capotostobnl/acmi2-hw-afe/3dmodels/TPS3850H33DRCR.STEP

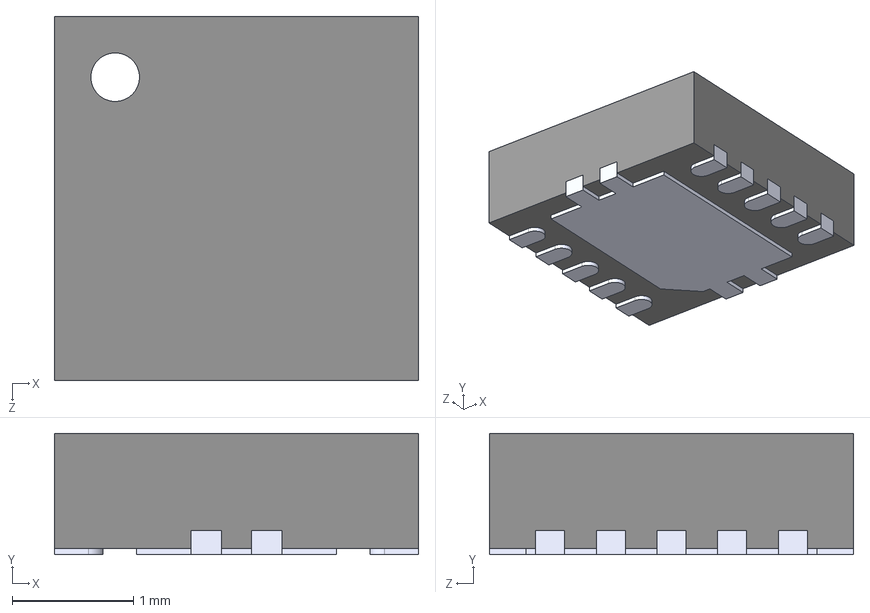
[picture p1: CAD file, 2026-05-26]
3dmodels/TPS3850H33DRCR.STEP
3.00 x 1.00 x 3.00 mm
