capotostobnl/acmi2-hw-afe/3dmodels/EEE-FTH101XAP.step

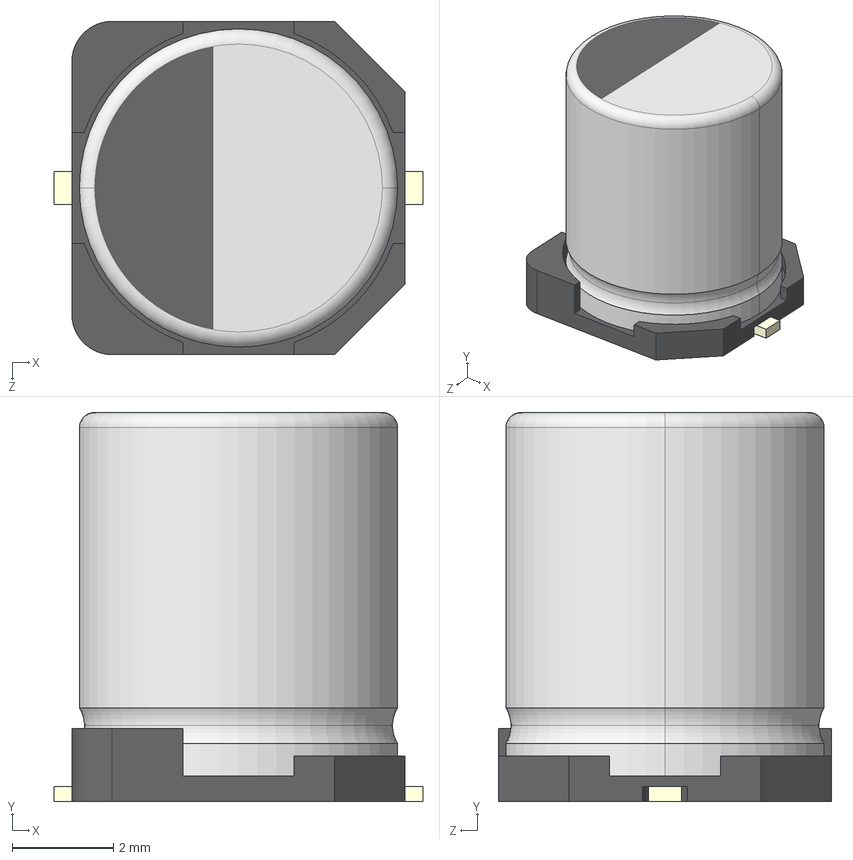
[picture p2: CAD file, 2026-04-29]
3dmodels/EEE-FTH101XAP.step
7.30 x 7.70 x 6.60 mm
標準SIZE CODE D8-001
標準SIZE CODE D8-002
標準SIZE CODE D8-003 x 2
