capotostobnl/acmi2-hw-afe/3dmodels/c-1625854-1-ba-3d.step

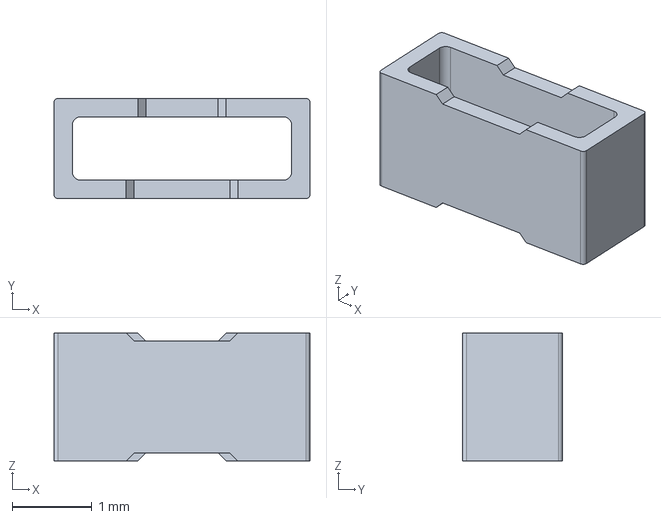
[picture p3: CAD file, 2026-04-29]
3dmodels/c-1625854-1-ba-3d.step
3.20 x 1.25 x 1.60 mm
