capotostobnl/acmi2-hw-afe/3dmodels/FUSE_SMDC300F24-2_LTF.step

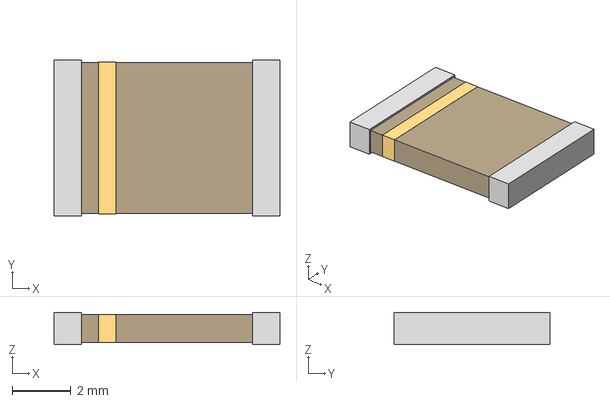
[picture p4: CAD file, 2026-04-29]
3dmodels/FUSE_SMDC300F24-2_LTF.step
7.70 x 5.31 x 1.09 mm
