capotostobnl/acmi2-hw-afe/3dmodels/KRL2012E-M-R220-F-T5.step

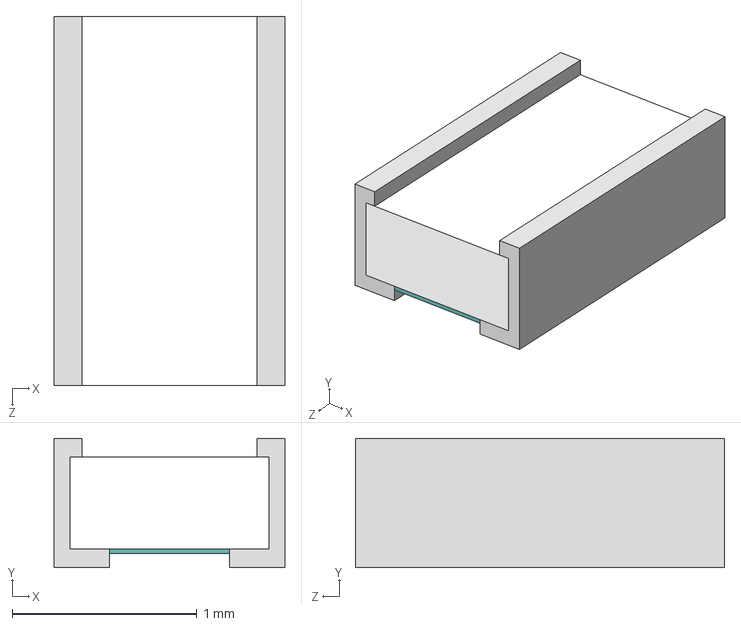
[picture p5: CAD file, 2026-04-29]
3dmodels/KRL2012E-M-R220-F-T5.step
1.25 x 0.7 x 2.00 mm
