capotostobnl/acmi2-hw-afe/3dmodels/SN74LVC16T245DGGR.STEP

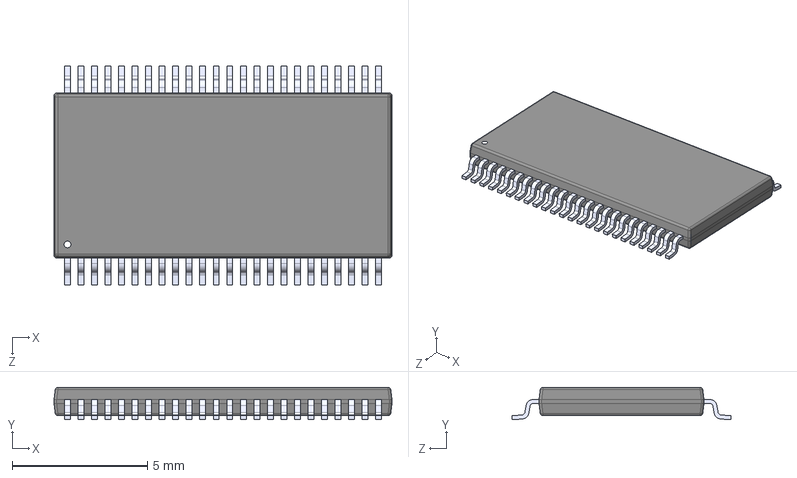
[picture p6: CAD file, 2026-04-29]
3dmodels/SN74LVC16T245DGGR.STEP
12.5 x 1.20 x 8.10 mm
