capotostobnl/acmi2-hw-afe/3dmodels/LTC2991CMS_TRPBF.step

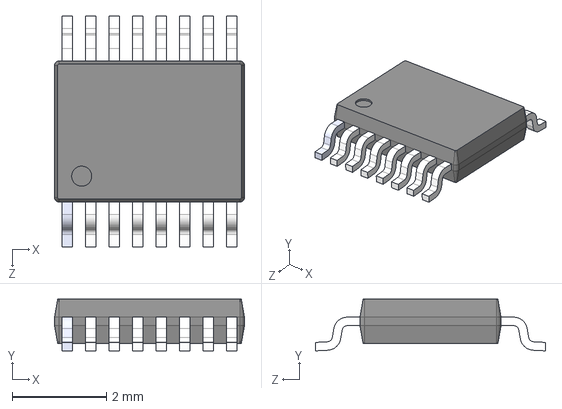
[picture p7: CAD file, 2026-04-29]
3dmodels/LTC2991CMS_TRPBF.step
4.04 x 1.10 x 4.90 mm
