capotostobnl/acmi2-hw-afe/3dmodels/RES_6432_SUS.step

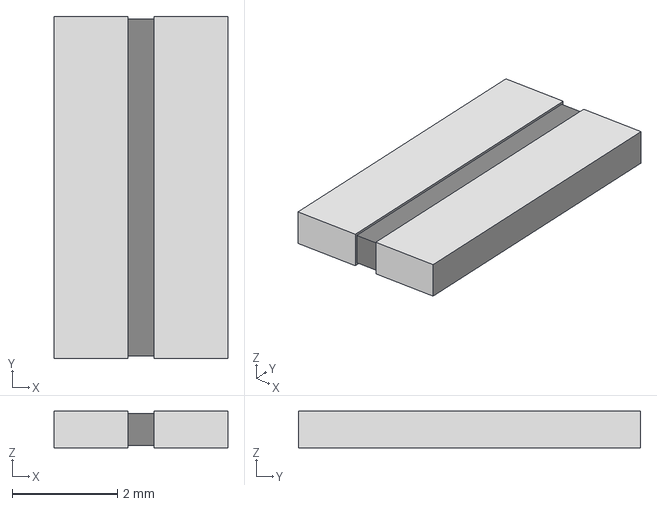
[picture p8: CAD file, 2026-04-29]
3dmodels/RES_6432_SUS.step
3.30 x 6.50 x 0.7 mm
