capotostobnl/acmi2-hw-afe/3dmodels/MSOP-8_MS_LIT.step

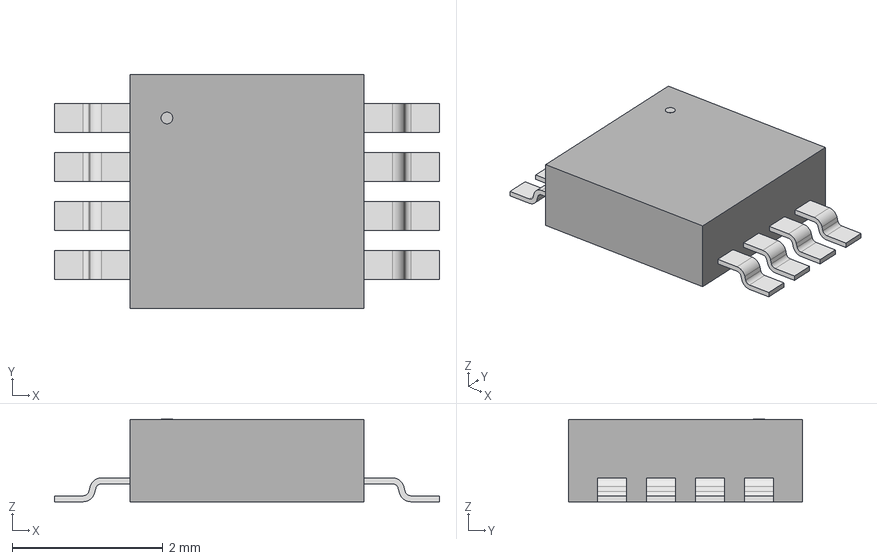
[picture p9: CAD file, 2026-04-29]
3dmodels/MSOP-8_MS_LIT.step
5.11 x 3.10 x 1.09 mm
