capotostobnl/acmi2-hw-afe/3dmodels/3-641215-6-z-3d.step

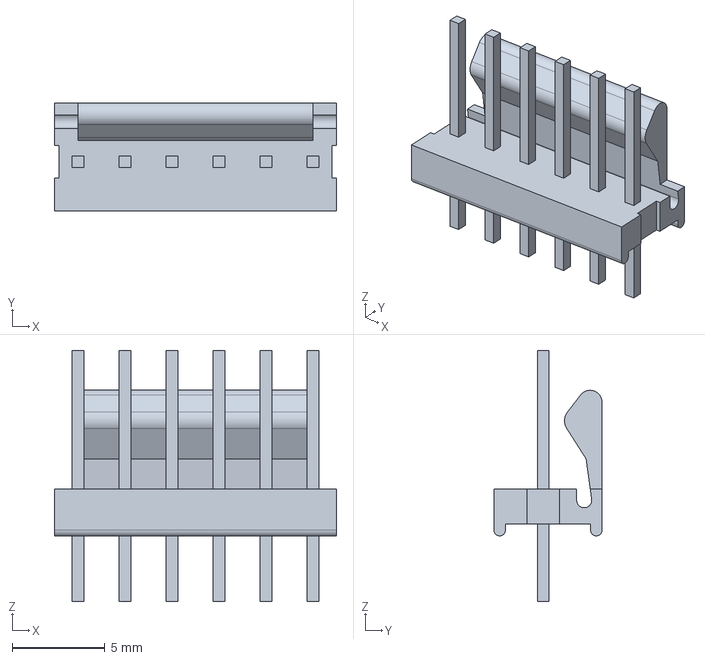
[picture p10: CAD file, 2026-04-29]
3dmodels/3-641215-6-z-3d.step
15.2 x 5.84 x 13.6 mm
