capotostobnl/acmi2-hw-afe/3dmodels/Coilcraft-MSS1048.step

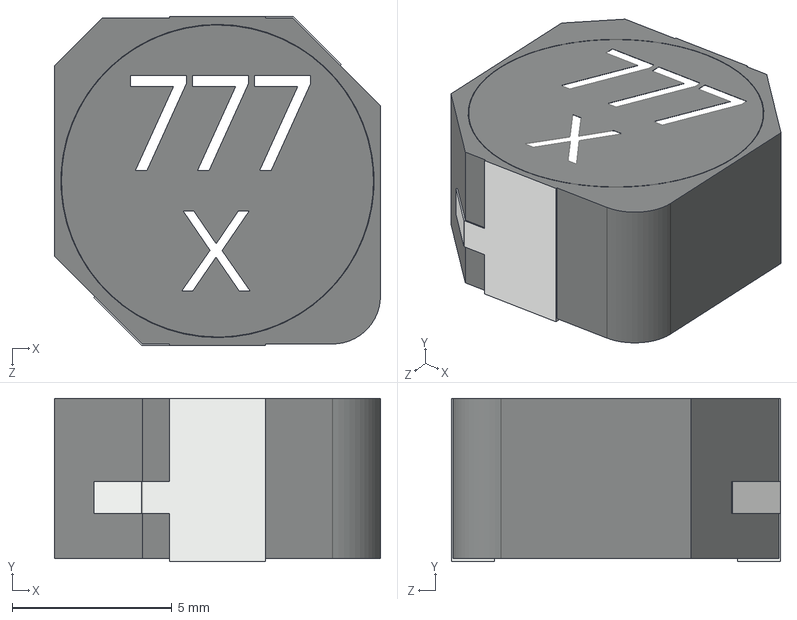
[picture p11: CAD file, 2026-04-29]
3dmodels/Coilcraft-MSS1048.step
10.2 x 5.10 x 10.3 mm
