capotostobnl/acmi2-hw-afe/3dmodels/Amphenol_10090926-P264XLF.step

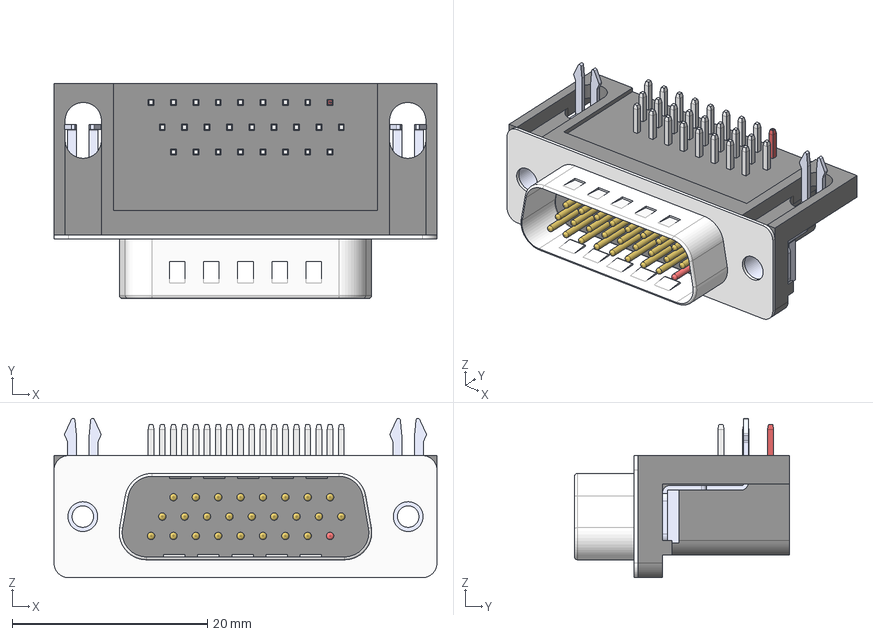
[picture p12: CAD file, 2026-04-29]
3dmodels/Amphenol_10090926-P264XLF.step
39.2 x 22.0 x 16.3 mm
