capotostobnl/acmi2-hw-afe/3dmodels/RDM0023A.stp

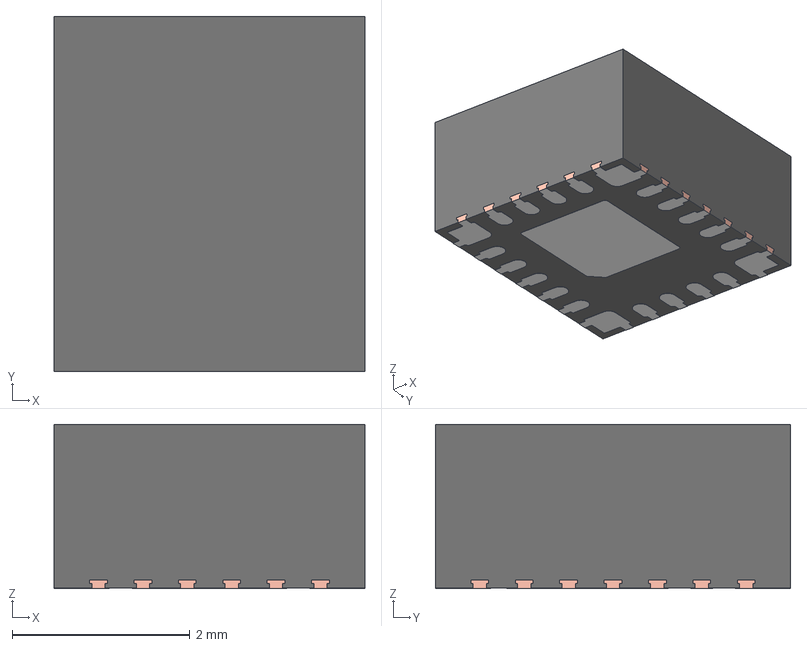
[picture p13: CAD file, 2026-04-29]
3dmodels/RDM0023A.stp
3.50 x 4.00 x 1.85 mm
FRAME
MOLD
