capotostobnl/acmi2-hw-afe/3dmodels/T521X107M025ATE060.step

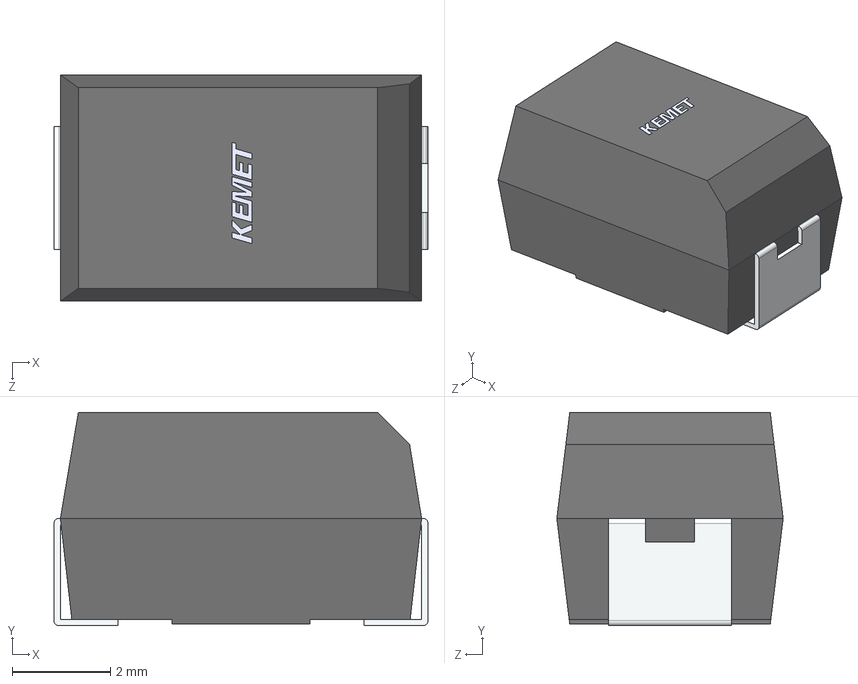
[picture p14: CAD file, 2026-04-29]
3dmodels/T521X107M025ATE060.step
7.60 x 4.34 x 4.60 mm
