capotostobnl/acmi2-hw-afe/3dmodels/ECS-LVDS33-2000-BN.STEP

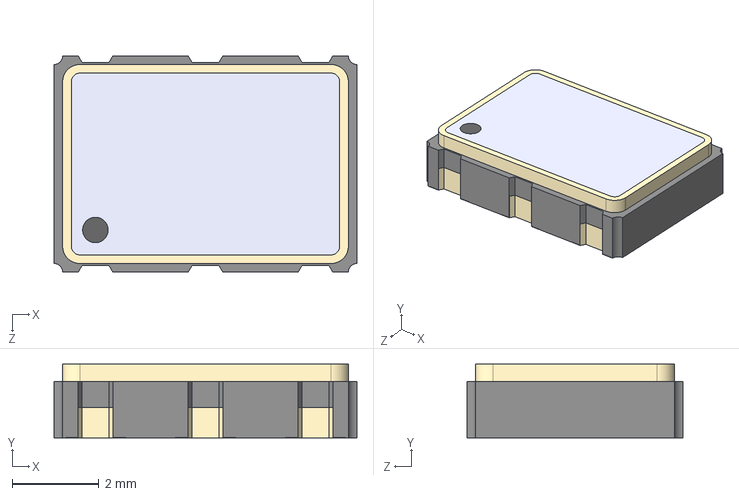
[picture p15: CAD file, 2026-04-29]
3dmodels/ECS-LVDS33-2000-BN.STEP
7.00 x 1.70 x 5.00 mm
