capotostobnl/acmi2-hw-afe/3dmodels/TPS7A8500RGRT.STEP

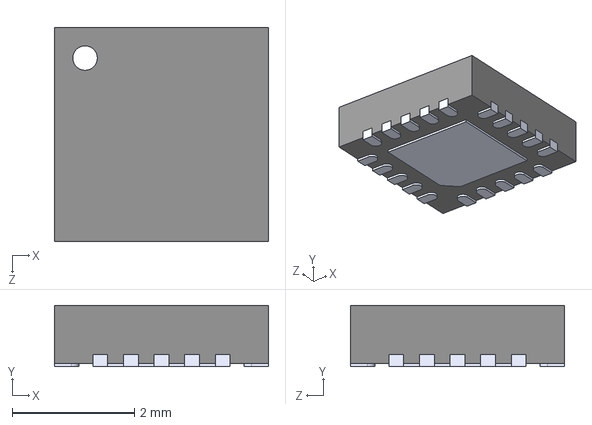
[picture p16: CAD file, 2026-04-29]
3dmodels/TPS7A8500RGRT.STEP
3.50 x 1.00 x 3.50 mm
