capotostobnl/acmi2-hw-afe/3dmodels/LT3015EDDPBF.step

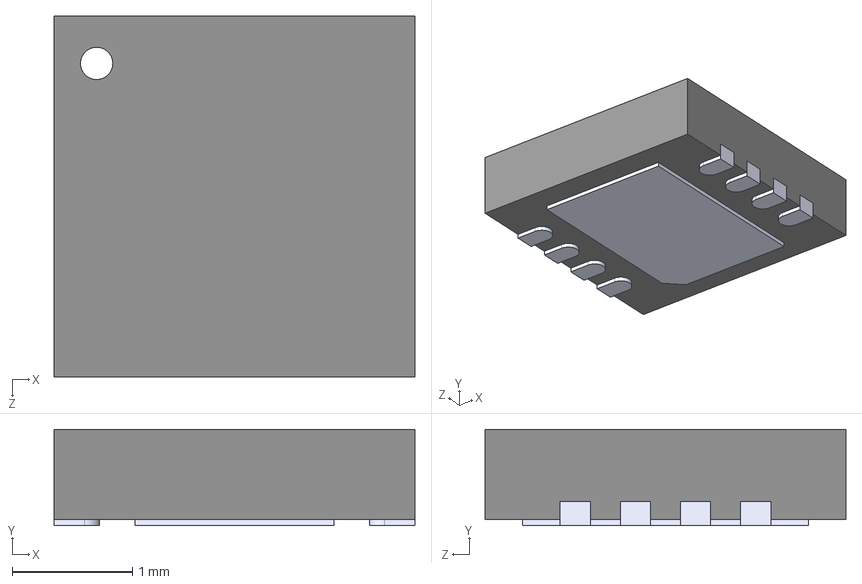
[picture p17: CAD file, 2026-04-29]
3dmodels/LT3015EDDPBF.step
3.00 x 0.8 x 3.00 mm
