capotostobnl/acmi2-hw-afe/3dmodels/PW0016A.step

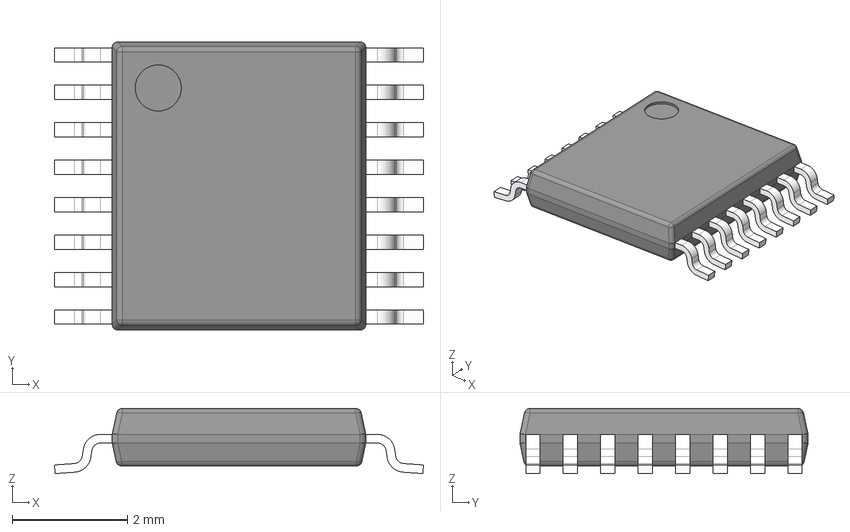
[picture p18: CAD file, 2026-04-29]
3dmodels/PW0016A.step
6.40 x 5.00 x 1.13 mm
BODY-TSSOP
LEAD-TSSOP x 16
PIN1
