capotostobnl/acmi2-hw-afe/3dmodels/IND_LSMG_160808_TAY.step

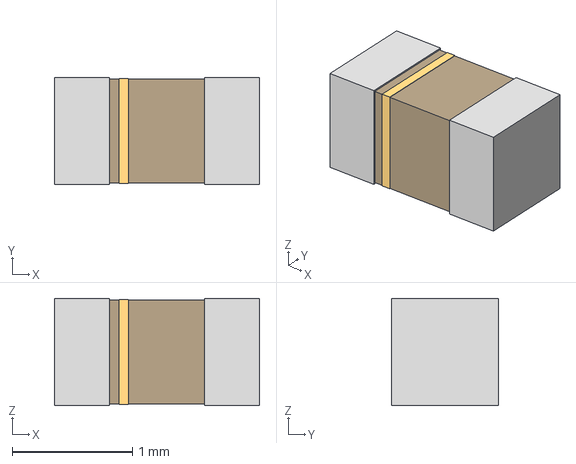
[picture p19: CAD file, 2026-04-29]
3dmodels/IND_LSMG_160808_TAY.step
1.70 x 0.888 x 0.889 mm
