capotostobnl/acmi2-hw-afe/(list of files, cad)

Other CAD files:
3dmodels/039301022.step
3dmodels/132134.stp
3dmodels/39301022.step
3dmodels/5499922-4-3d.stp
3dmodels/61082-061400LF.step
3dmodels/6469028-1.step
3dmodels/836149012.step
3dmodels/CAT25320VI-GT3.STEP
3dmodels/TPS259540DSGR.STEP
