capotostobnl/acmi2-hw-afe/Outputs/STEP/SK-2601-52_Rev-1_bottom.png

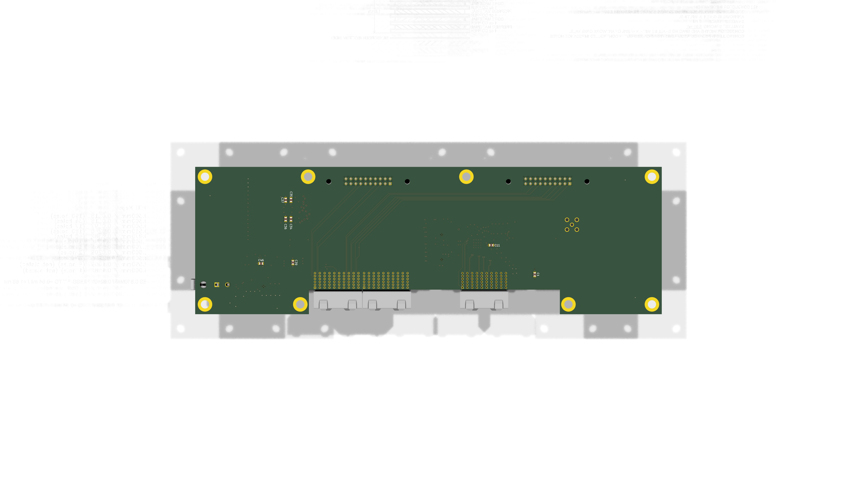
Outputs/STEP/SK-2601-52_Rev-1_bottom.png
