capotostobnl/acmi2-hw-afe/Outputs/STEP/SK-2601-52_Rev-1_top.png

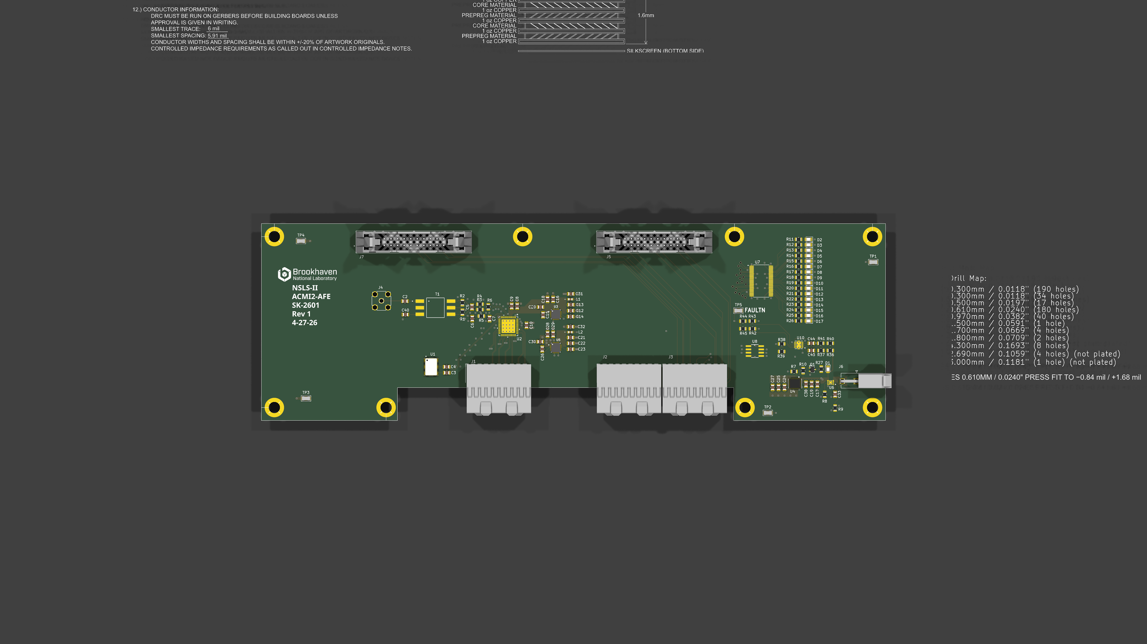
Outputs/STEP/SK-2601-52_Rev-1_top.png
