capotostobnl/acmi2-hw-afe/Outputs/ASSY/SK-2601-51_Rev-1.pdf

1 | 2 | 3 | 4 | 5 | 6 | 7 | 8 | 9 | 10 | 11

A

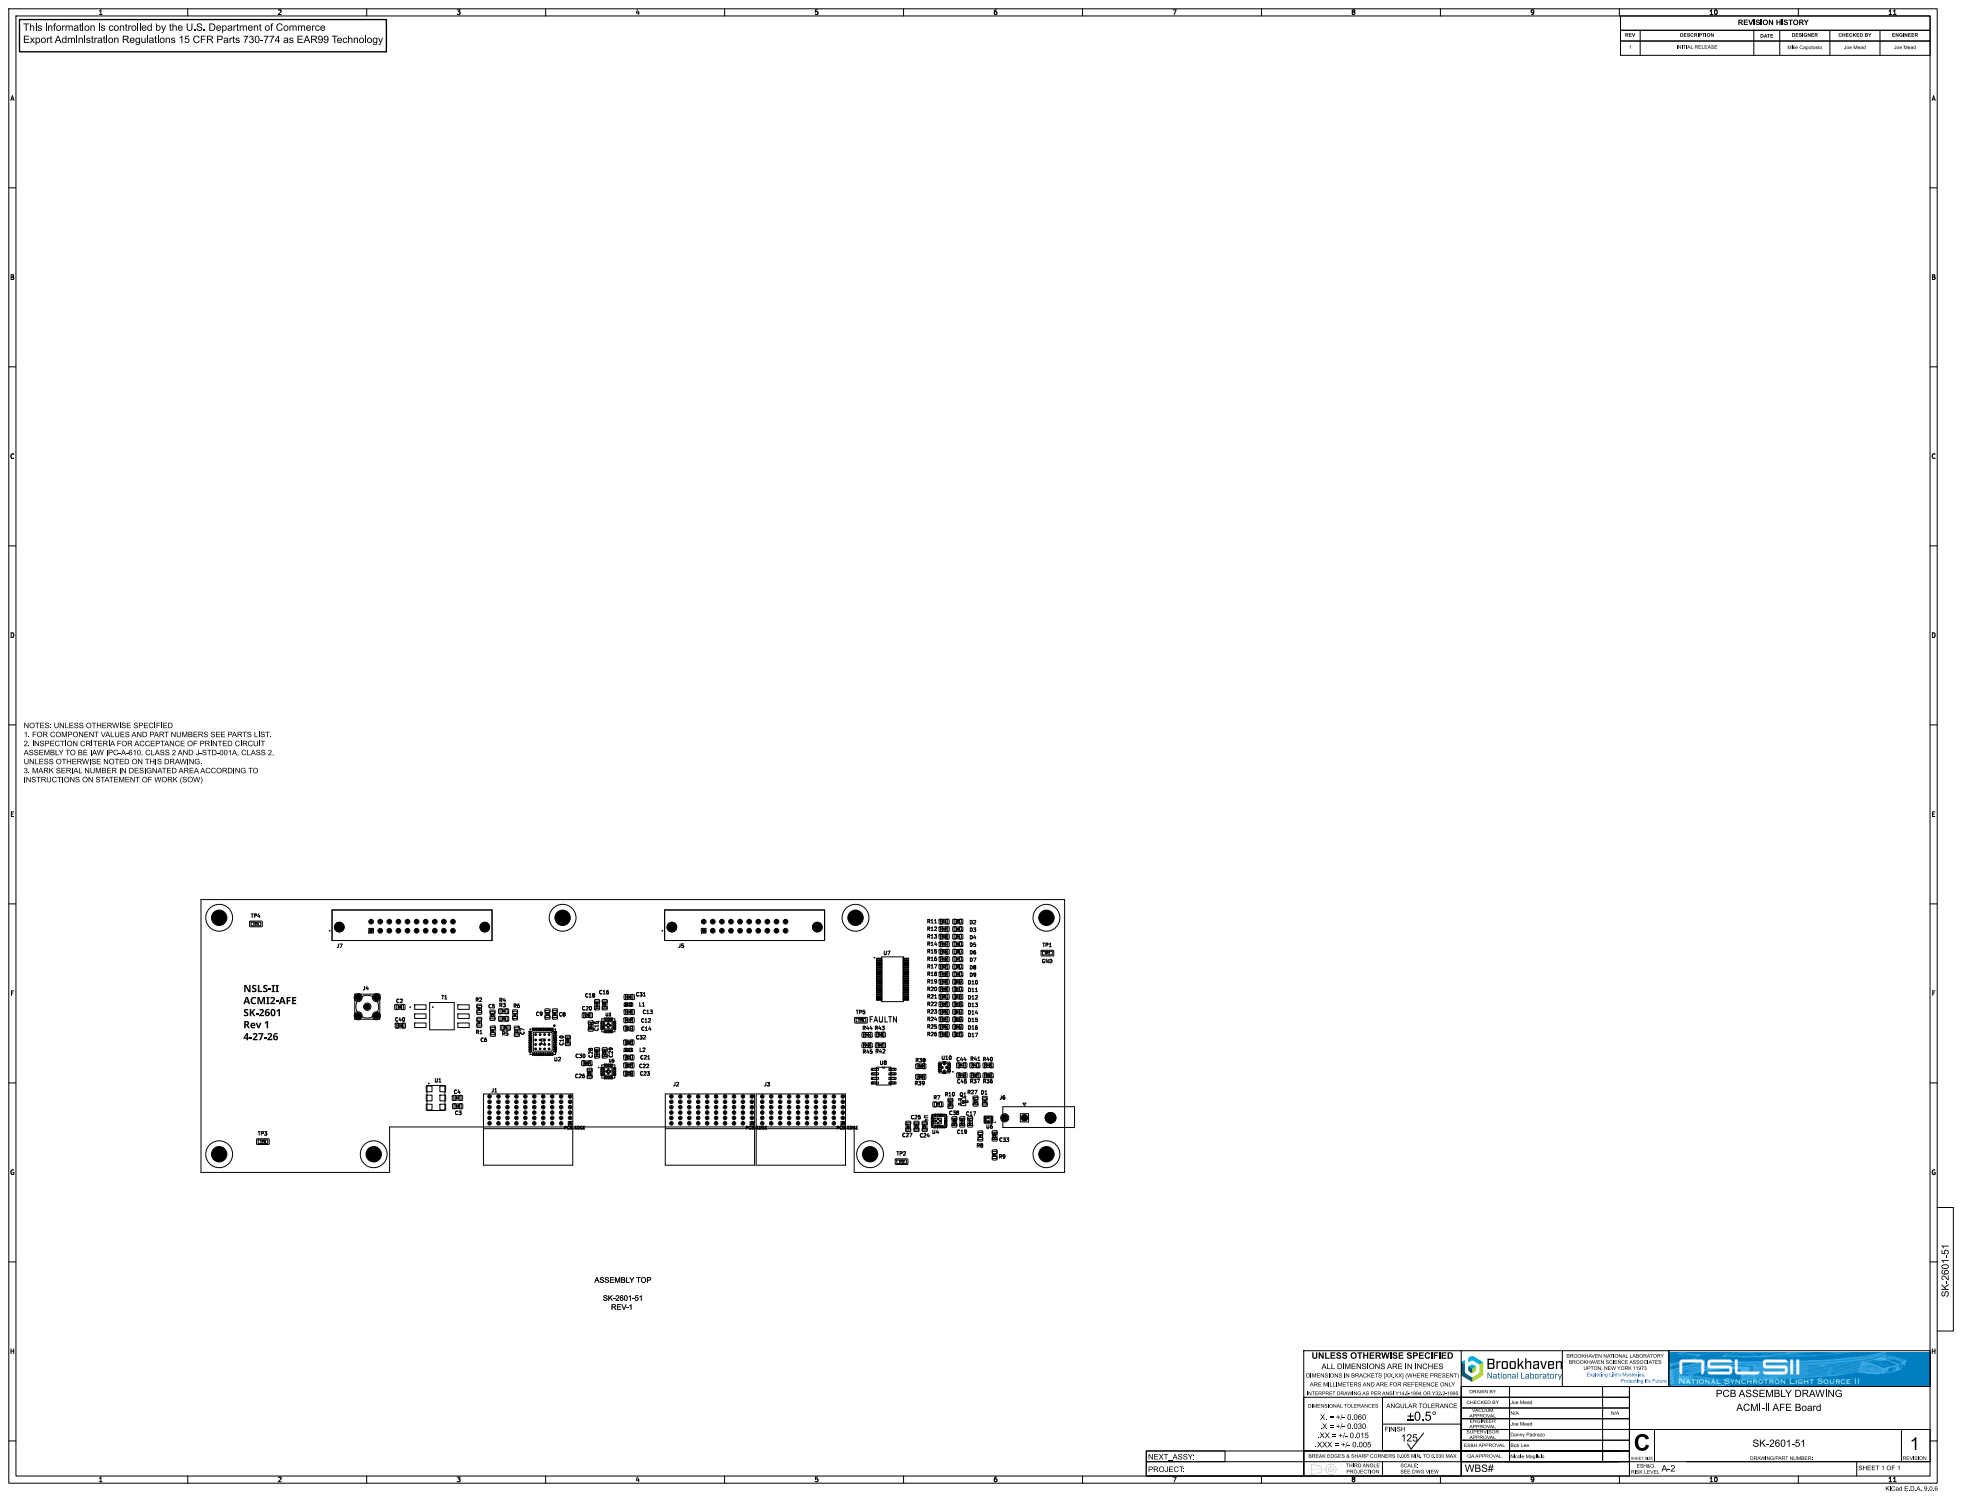
[picture p25: page 1]

This information is controlled by the U.S. Department of Commerce

SEE DWG VIEW UNLESS OTHERWISE SPECIFIED
ALL DIMENSIONS ARE IN INCHES
DIMENSIONS IN BRACKETS [XX.XX] (WHERE PRESENT) ARE MILLIMETERS AND ARE FOR REFERENCE ONLY

Exploring Life's Mysteries, Protecting it's Future PROJECT:

DRAWN BY QA APPROVAL SUPERVISOR
Joe Mead Bob Lee CHECKED BY

PCB ASSEMBLY DRAWING
ACMI-II AFE Board

BREAK EDGES & SHARP CORNERS 0.005 MIN. TO 0.030 MAX

1 | 2 | 3 | 4 | 5 | 6 | 7 | 8 | 9 | 10 | 11

A

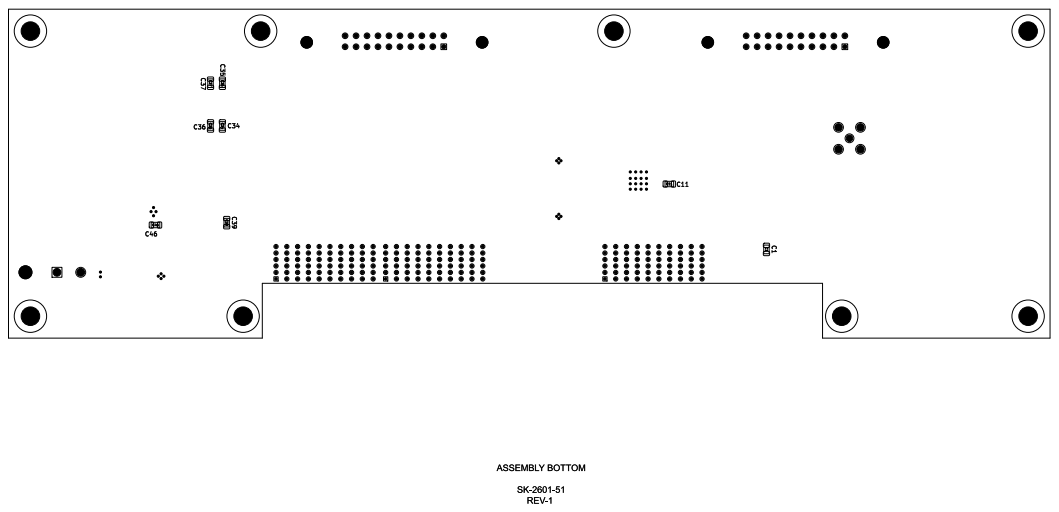
[picture p26: page 2]

This information is controlled by the U.S. Department of Commerce
