capotostobnl/acmi2-hw-afe/Outputs/FAB/SK-2601-52_Rev-1.pdf

## This information is controlled by the U.S. Department of Commerce

Export | Administration Regulations 15 CFR Parts 730-774 as EAR99 Technology | Not specified Controlled | Impedance | Top and Bottom Layers

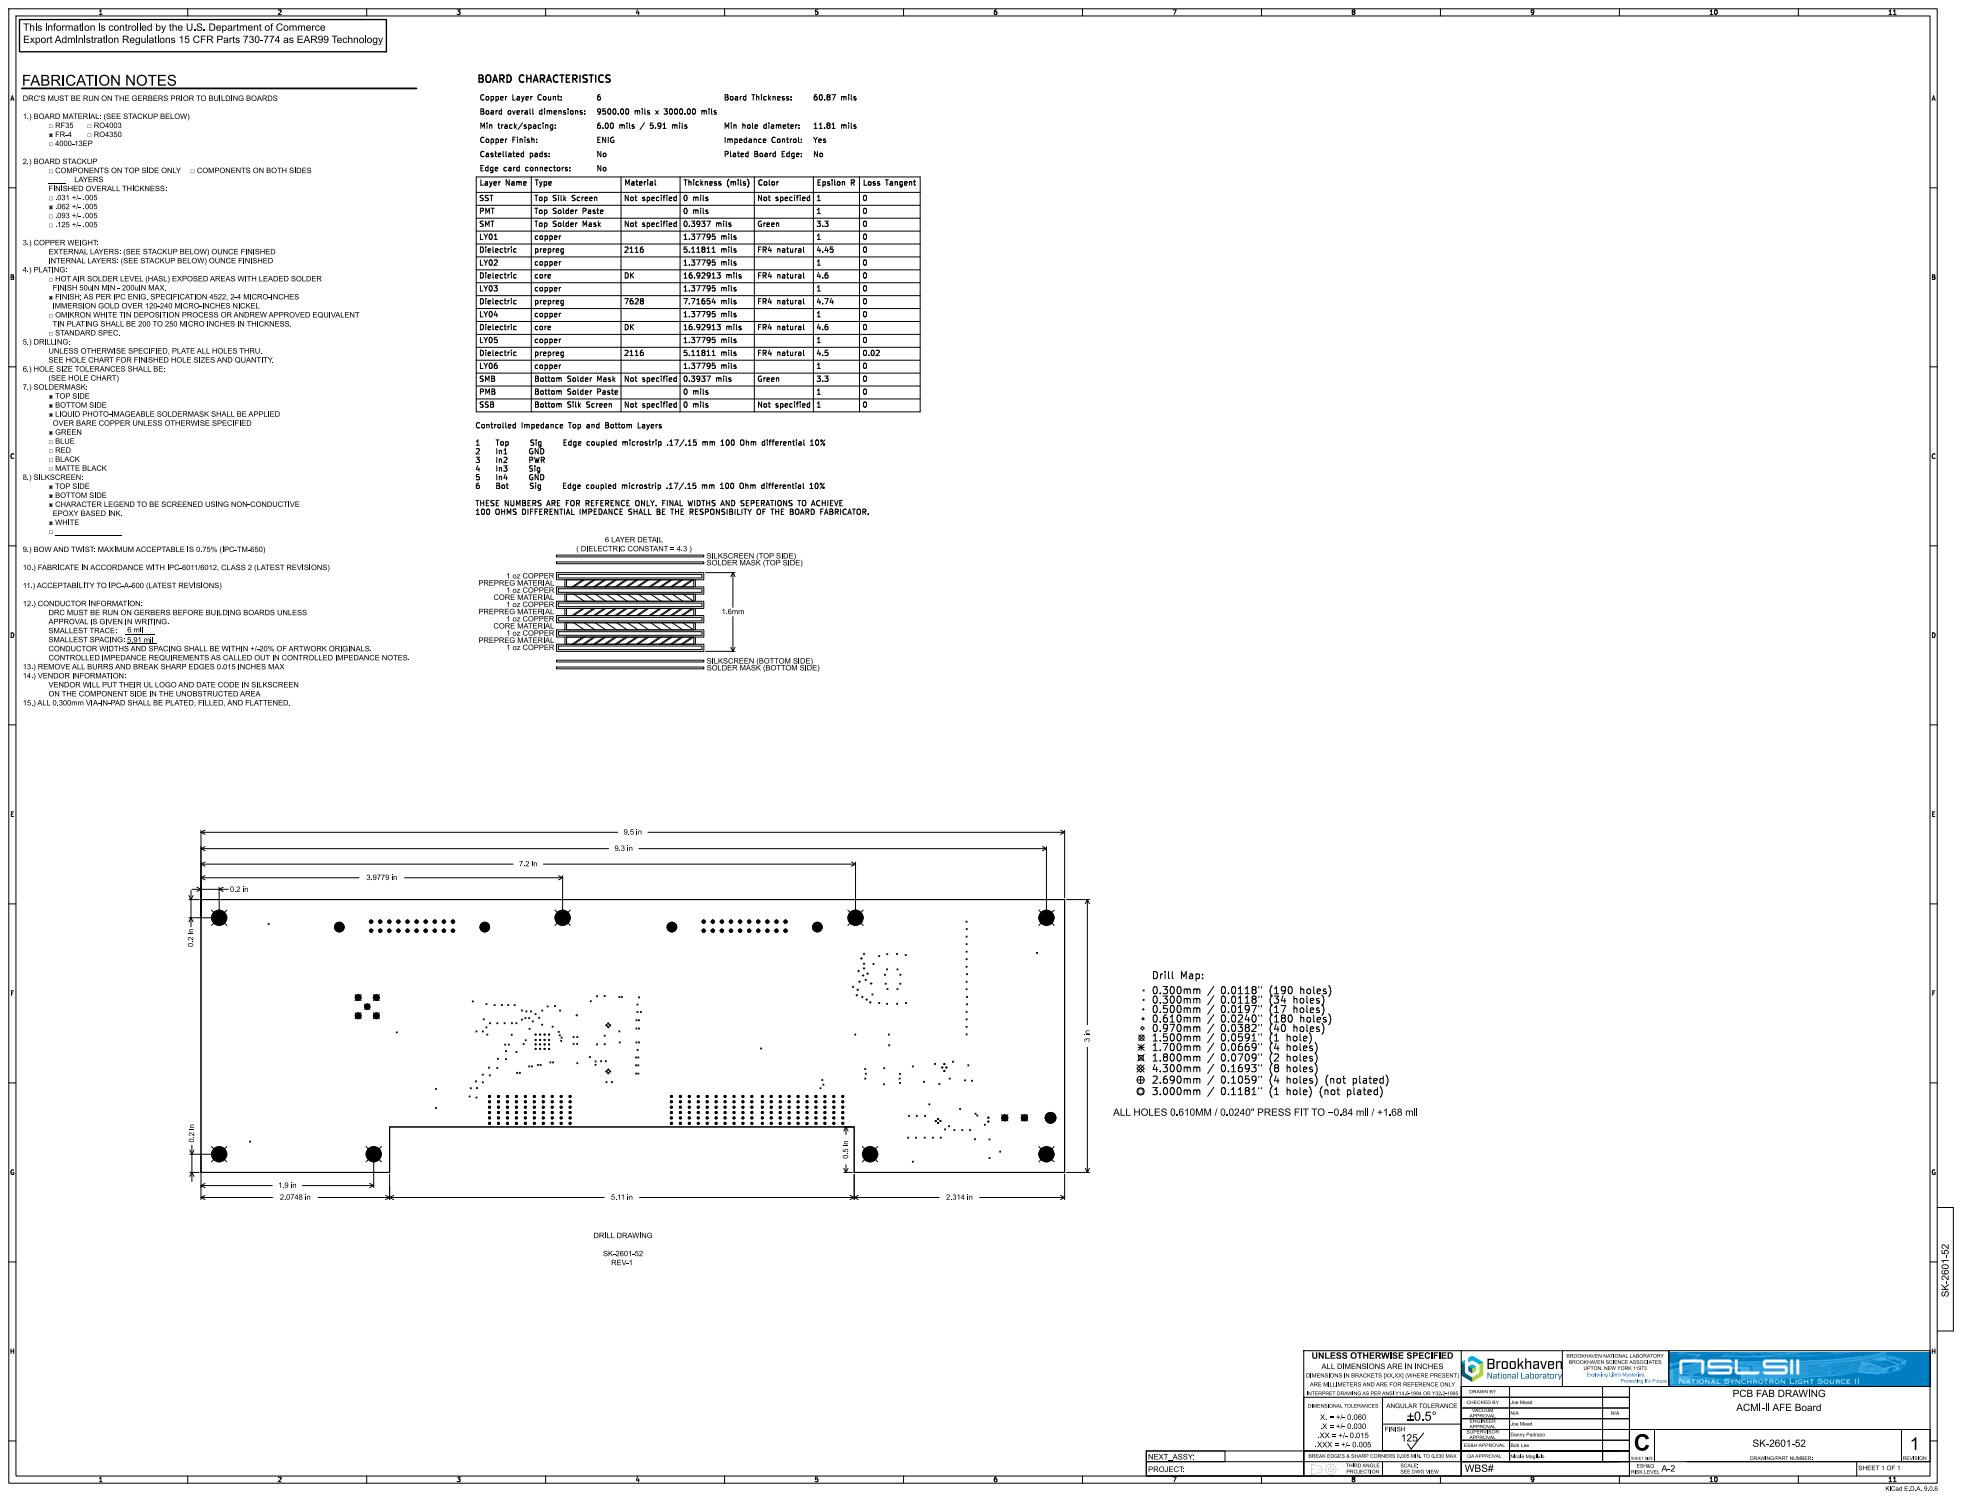
[picture p27: page 1]
SHEET SIZE; DRAWING/PART NUMBER:; REVISION; ESH&Q; RISK LEVEL; SHEET 1 OF 1; KiCad E.D.A. 9.0.6 SK-2601-52; Joe Mead Nicole Magliulo; VACUUM; APPROVAL; Danny Padrazo ES&H APPROVAL; ENGINEER; APPROVAL WBS#; .XXX = +/- 0.005; FINISH125; ANGULAR TOLERANCE; THIRD ANGLE; PROJECTION SCALE:; INTERPRET DRAWING AS PER ANSI Y14.5-1994 OR Y32.2-1995; BROOKHAVEN NATIONAL LABORATORY; 1 Top; þÿSig  Edge coupled microstrip; mm 100 Ohm differential; GND; þÿGND  6 Bot; Sig þÿ Edge coupled microstrip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

0 Yes Bottom Silk Screen PMT BOARD CHARACTERISTICS

0 ENIG
1.37795 mils Not specified No

Loss Tangent SMB

Type
1 Top Silk Screen

0 mils 1.37795 mils Not specified

7.71654 mils Not specified

THESE NUMBERS ARE FOR REFERENCE ONLY. FINAL WIDTHS AND SEPERATIONS TO ACHIEVE

H SK⁻²⁶⁰¹⁻⁵²

UPTON, NEW YORK 11973 NEXT_ASSY:

SEE DWG VIEW UNLESS OTHERWISE SPECIFIED
ALL DIMENSIONS ARE IN INCHES
DIMENSIONS IN BRACKETS [XX.XX] (WHERE PRESENT) ARE MILLIMETERS AND ARE FOR REFERENCE ONLY

BROOKHAVEN SCIENCE ASSOCIATES

Exploring Life's Mysteries, Protecting it's Future PROJECT:

DRAWN BY QA APPROVAL SUPERVISOR
Joe Mead Bob Lee CHECKED BY

PCB FAB DRAWING
ACMI-II AFE Board

APPROVAL DIMENSIONAL TOLERANCES X. = +/- 0.060

BREAK EDGES & SHARP CORNERS 0.005 MIN. TO 0.030 MAX

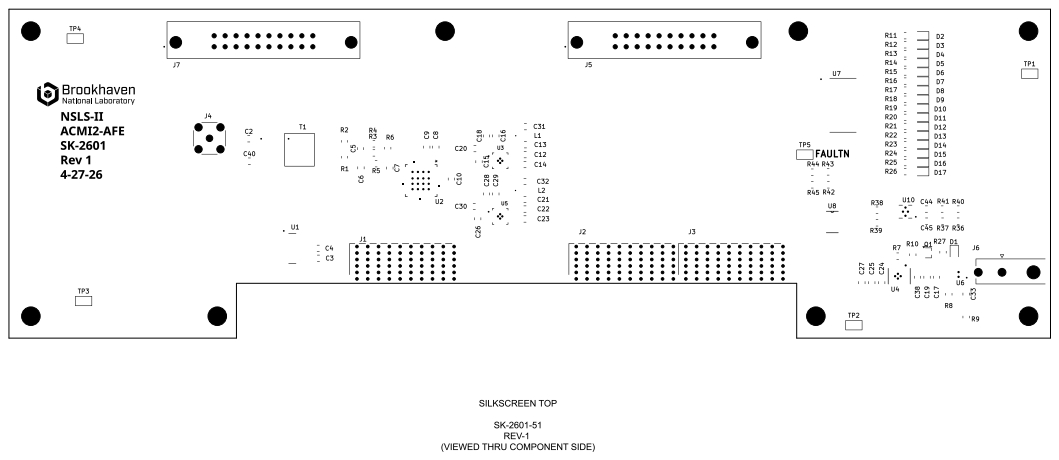
[picture p28: page 2]

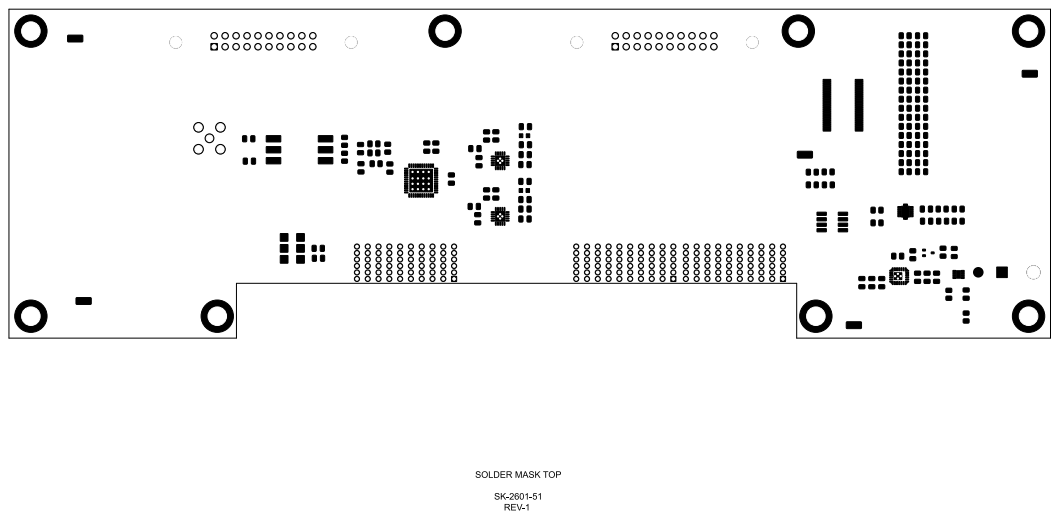
[picture p29: page 3]

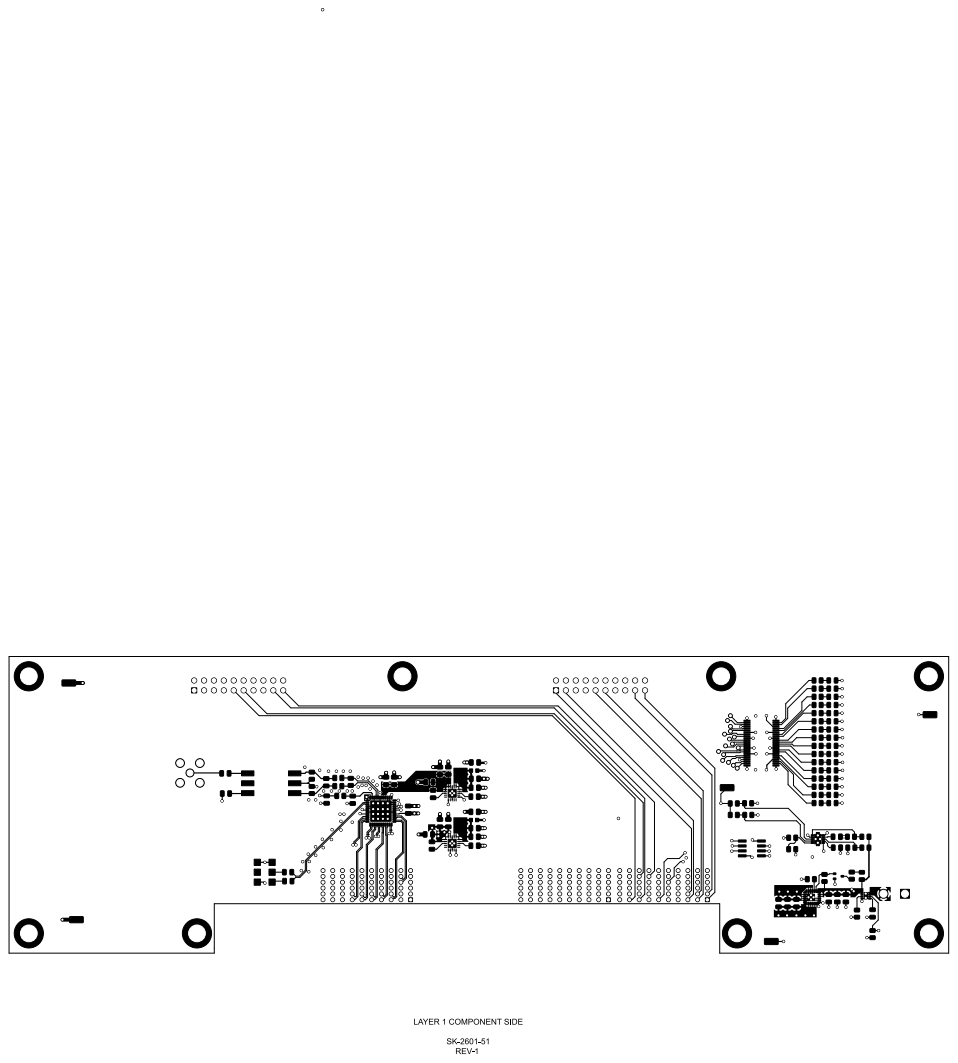
[picture p30: page 4]

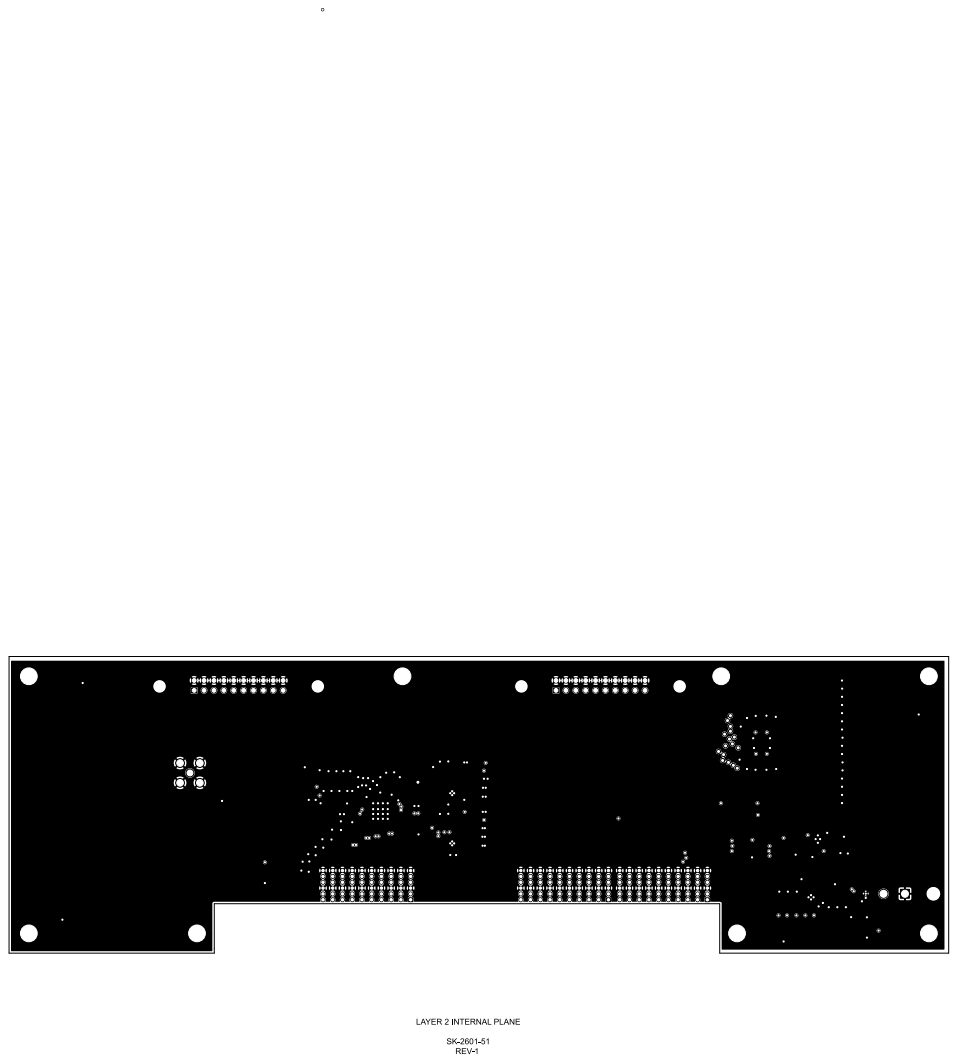
[picture p31: page 5]

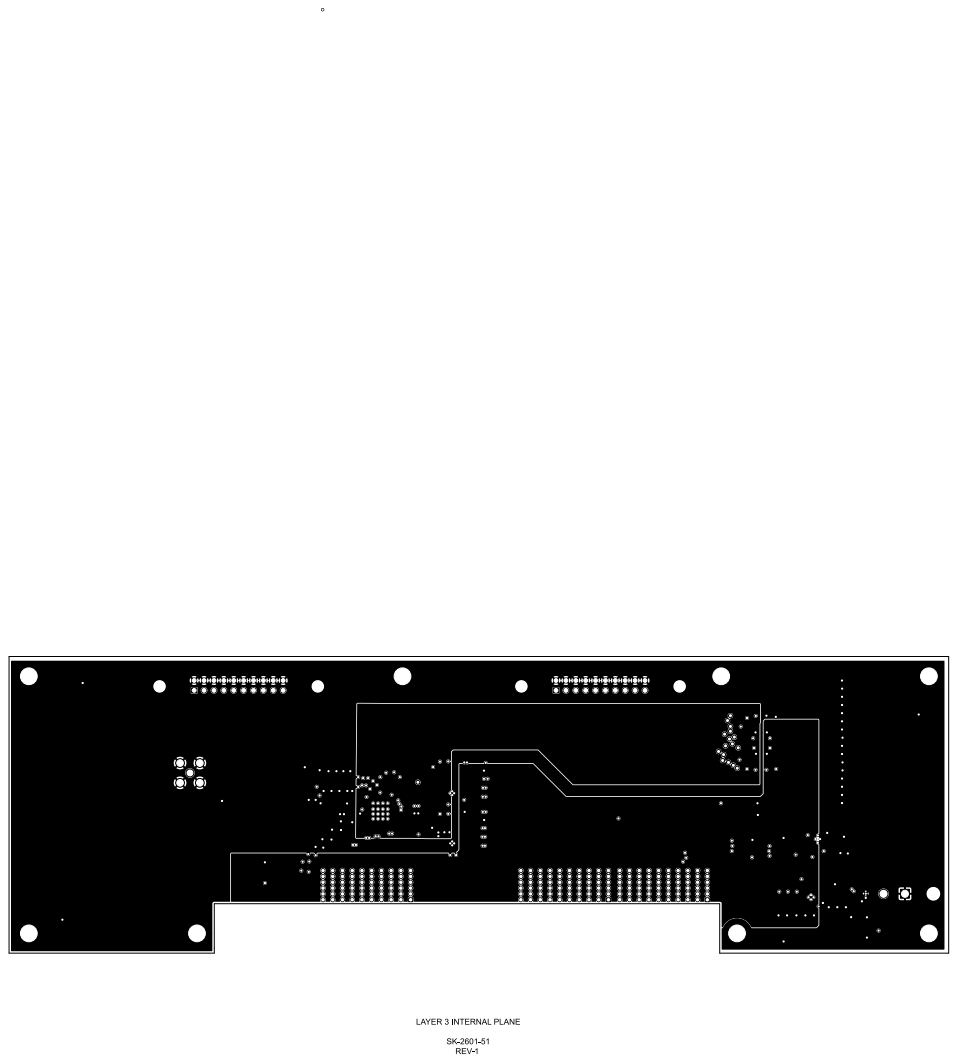
[picture p32: page 6]

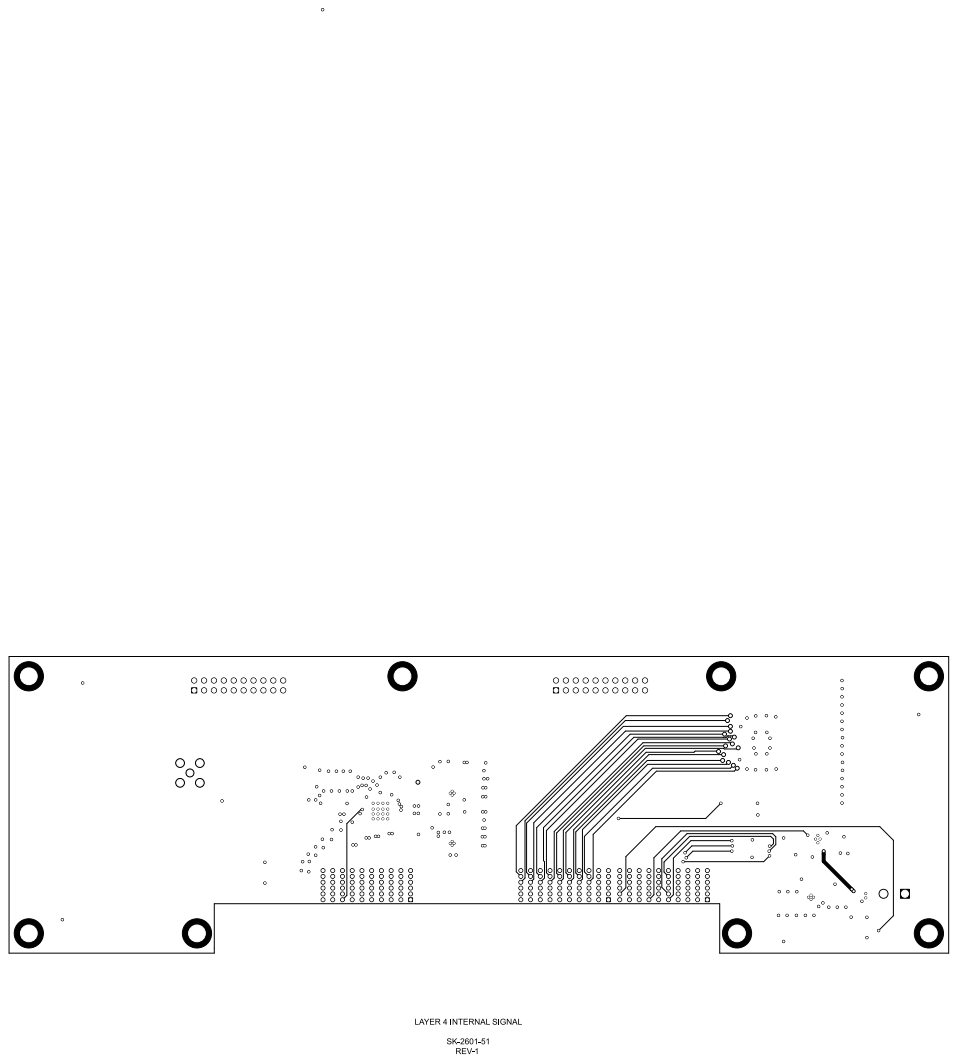
[picture p33: page 7]

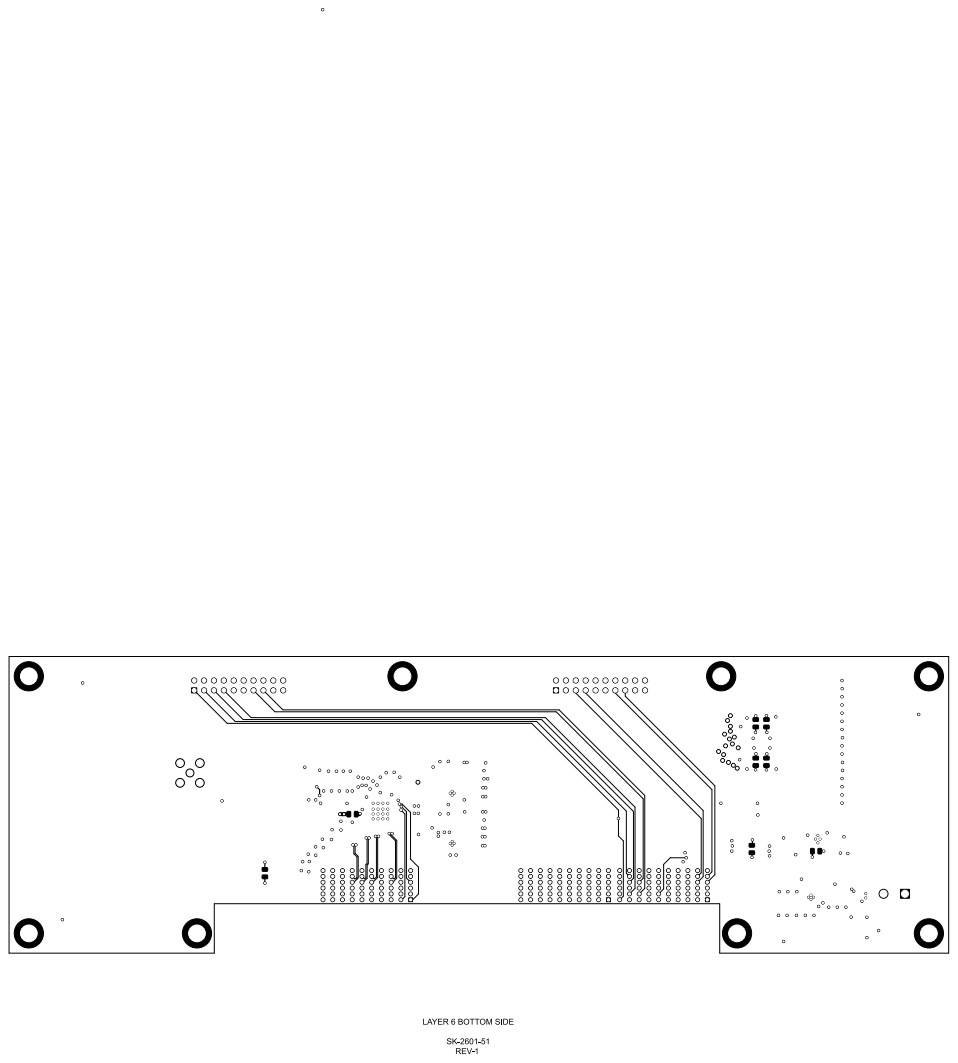
[picture p34: page 9]

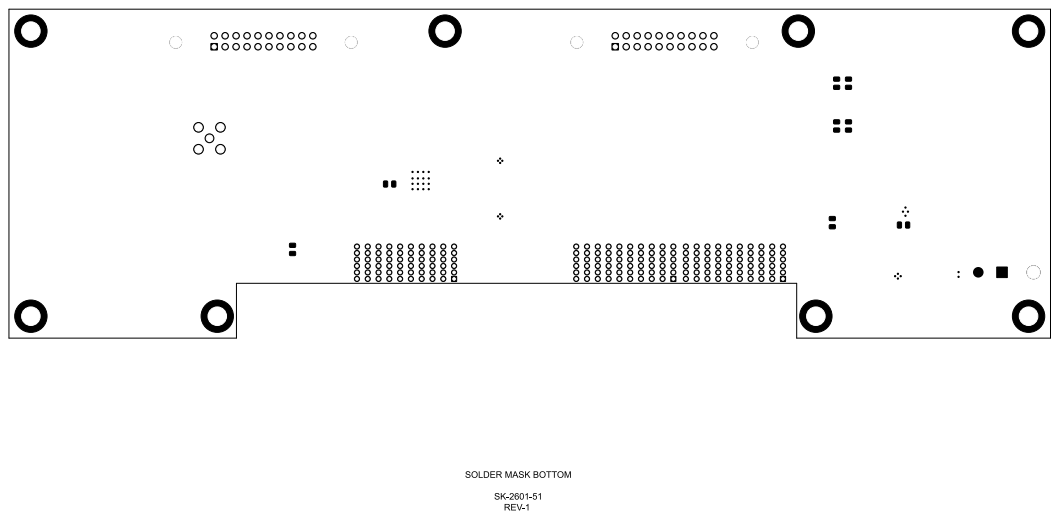
[picture p35: page 10]

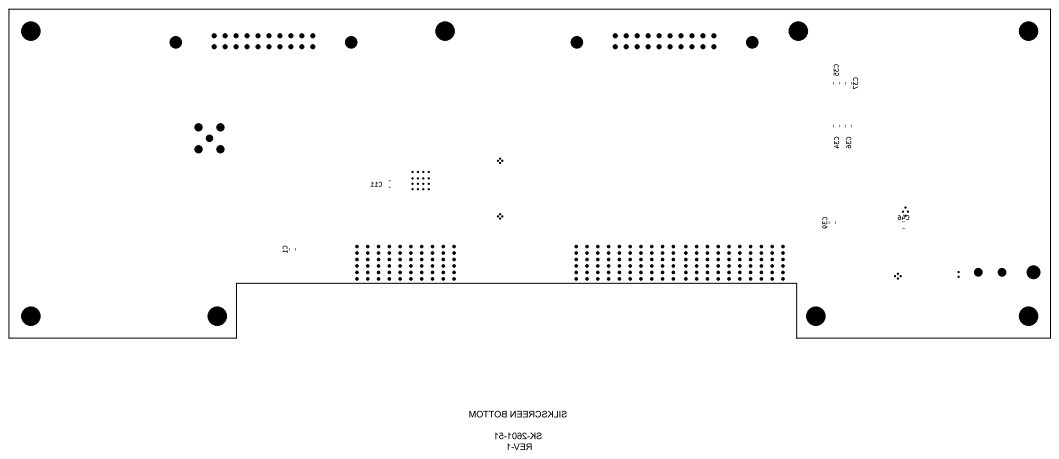
[picture p36: page 11]
