capotostobnl/acmi2-hw-afe/Outputs/SCH/SK-2601-53_Rev-1.pdf

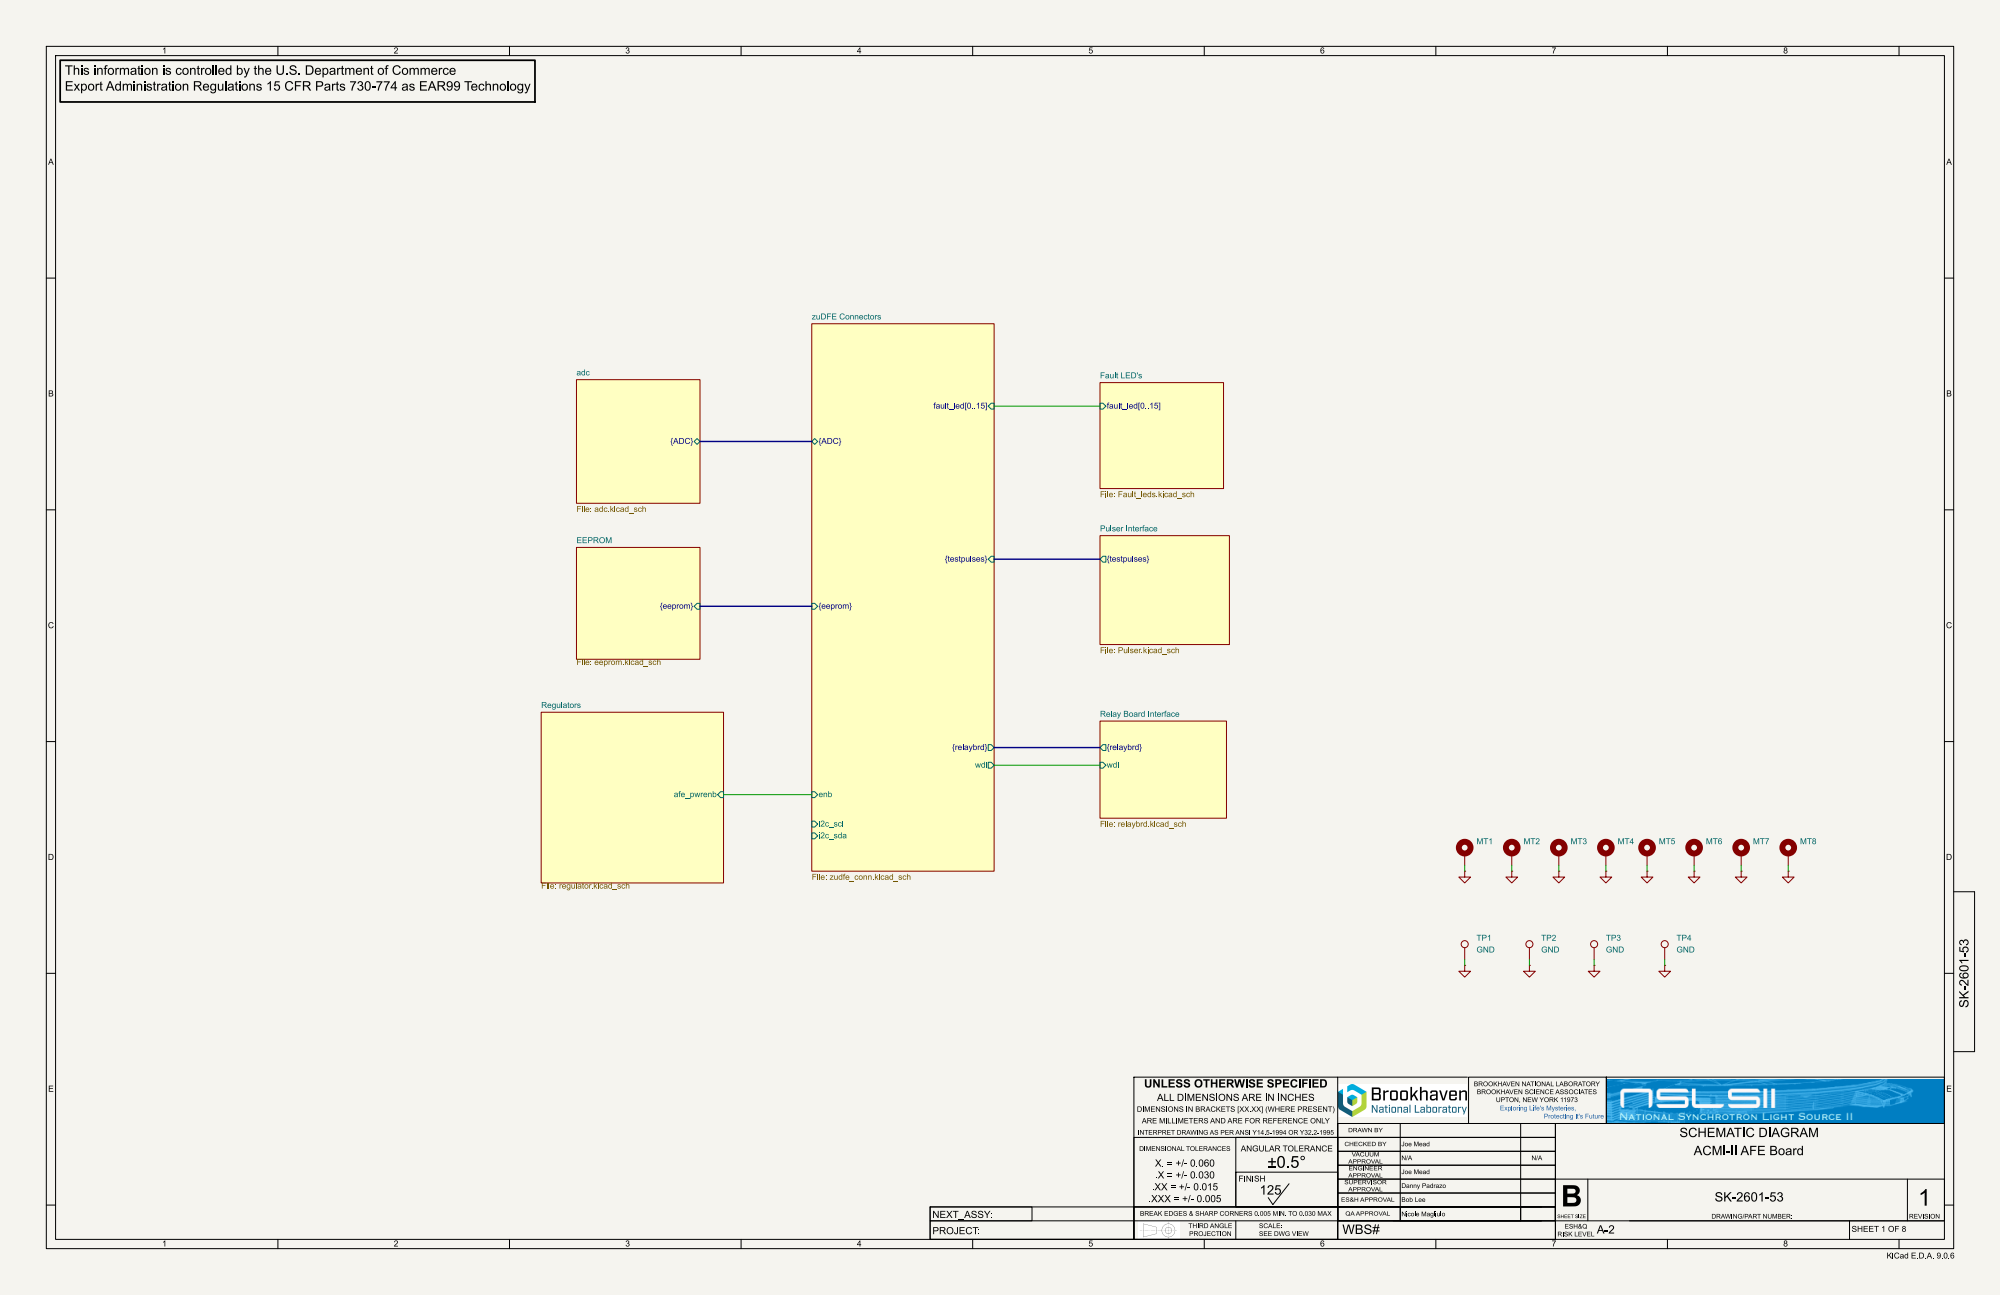
[picture p37: page 1]

This information is controlled by the U.S. Department of Commerce

{ADC} adc File: adc.kicad_sch

{testpulses} Pulser Interface File: Pulser.kicad_sch

{relaybrd} wdi Relay Board Interface File: relaybrd.kicad_sch

SEE DWG VIEW UNLESS OTHERWISE SPECIFIED
ALL DIMENSIONS ARE IN INCHES
DIMENSIONS IN BRACKETS [XX.XX] (WHERE PRESENT) ARE MILLIMETERS AND ARE FOR REFERENCE ONLY

Exploring Life's Mysteries, Protecting it's Future PROJECT:

DRAWN BY QA APPROVAL SUPERVISOR
Joe Mead Bob Lee CHECKED BY

SCHEMATIC DIAGRAM
ACMI-II AFE Board

APPROVAL WBS# | RISK LEVEL SHEET SIZE | SHEET 1 OF 8 DRAWING/PART NUMBER: | 1 REVISION

BREAK EDGES & SHARP CORNERS 0.005 MIN. TO 0.030 MAX

THIRD ANGLE PROJECTION SCALE: | | ESH&Q

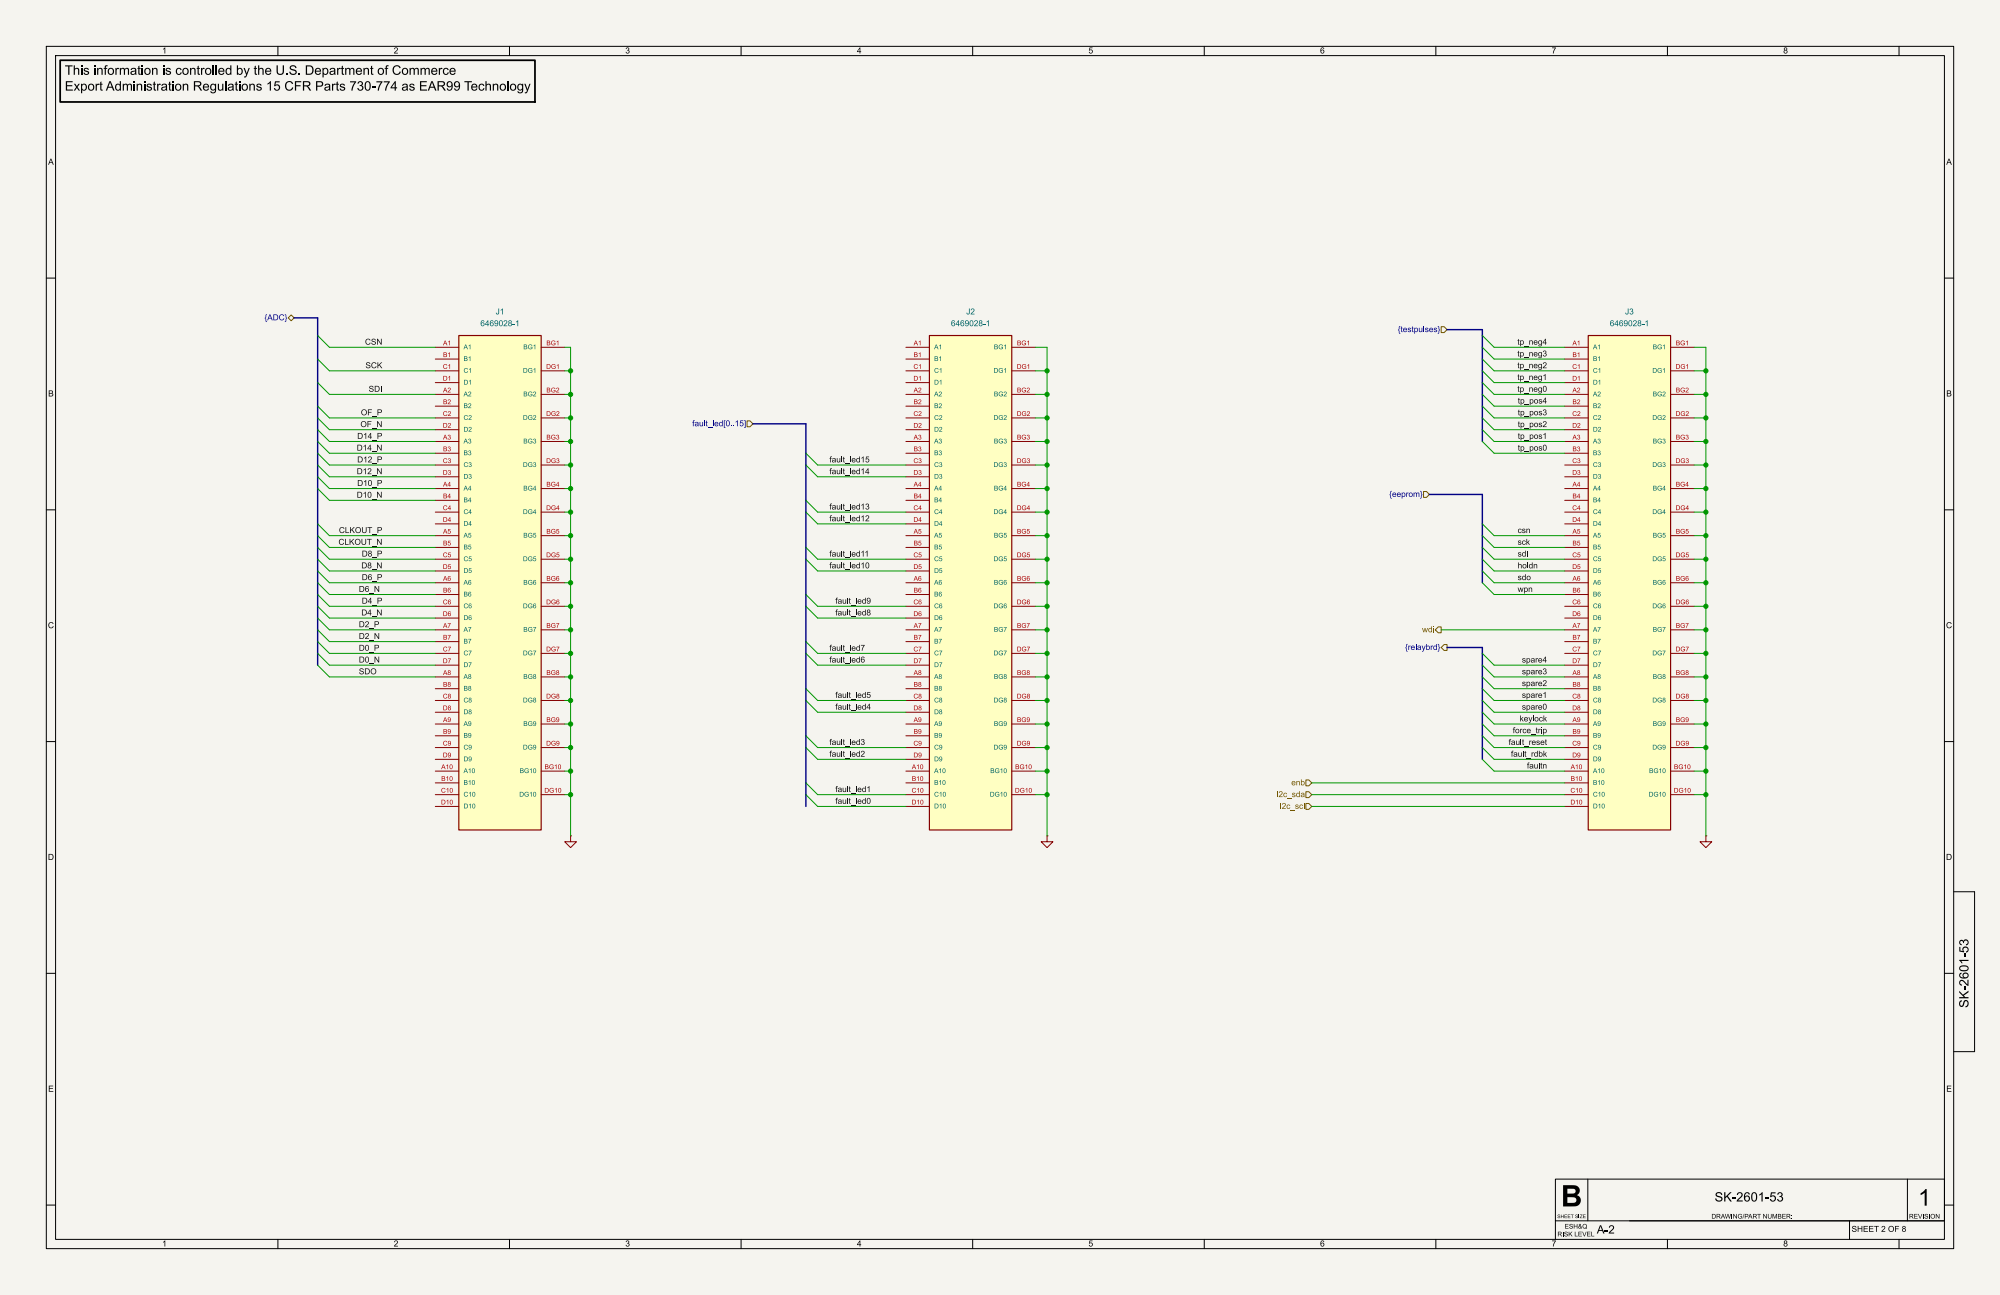
[picture p38: page 2]

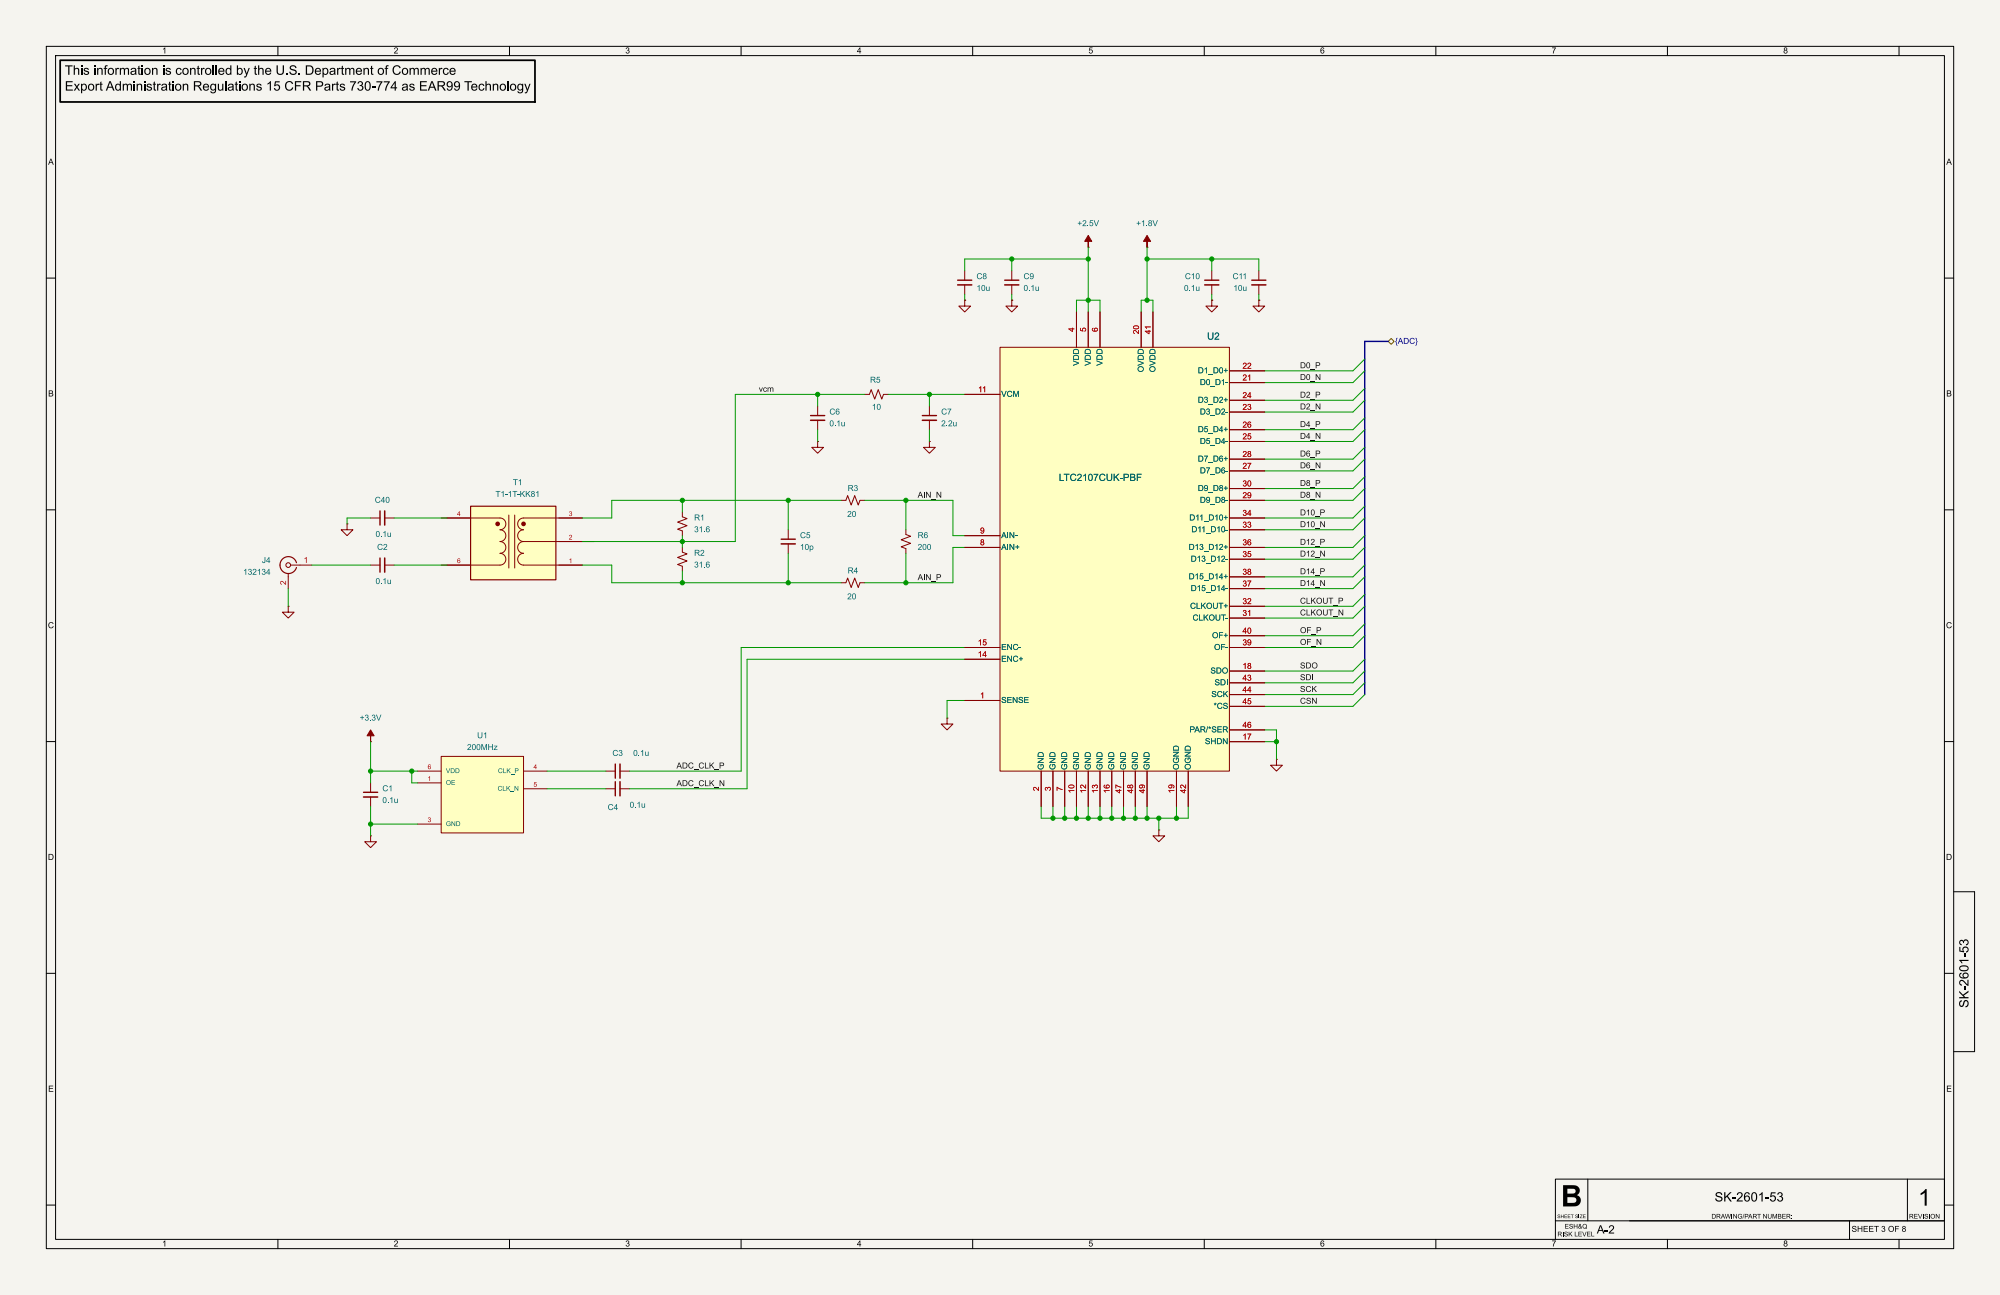
[picture p39: page 3]

6 GND 13 GND 16 GND 47 GND 48 OVDD 20 GND 49 OVDD 41 OGND 19 OGND 42 CLKOUT+ 32 CLKOUT- 31 SDO 18 SDI 43 SCK 44

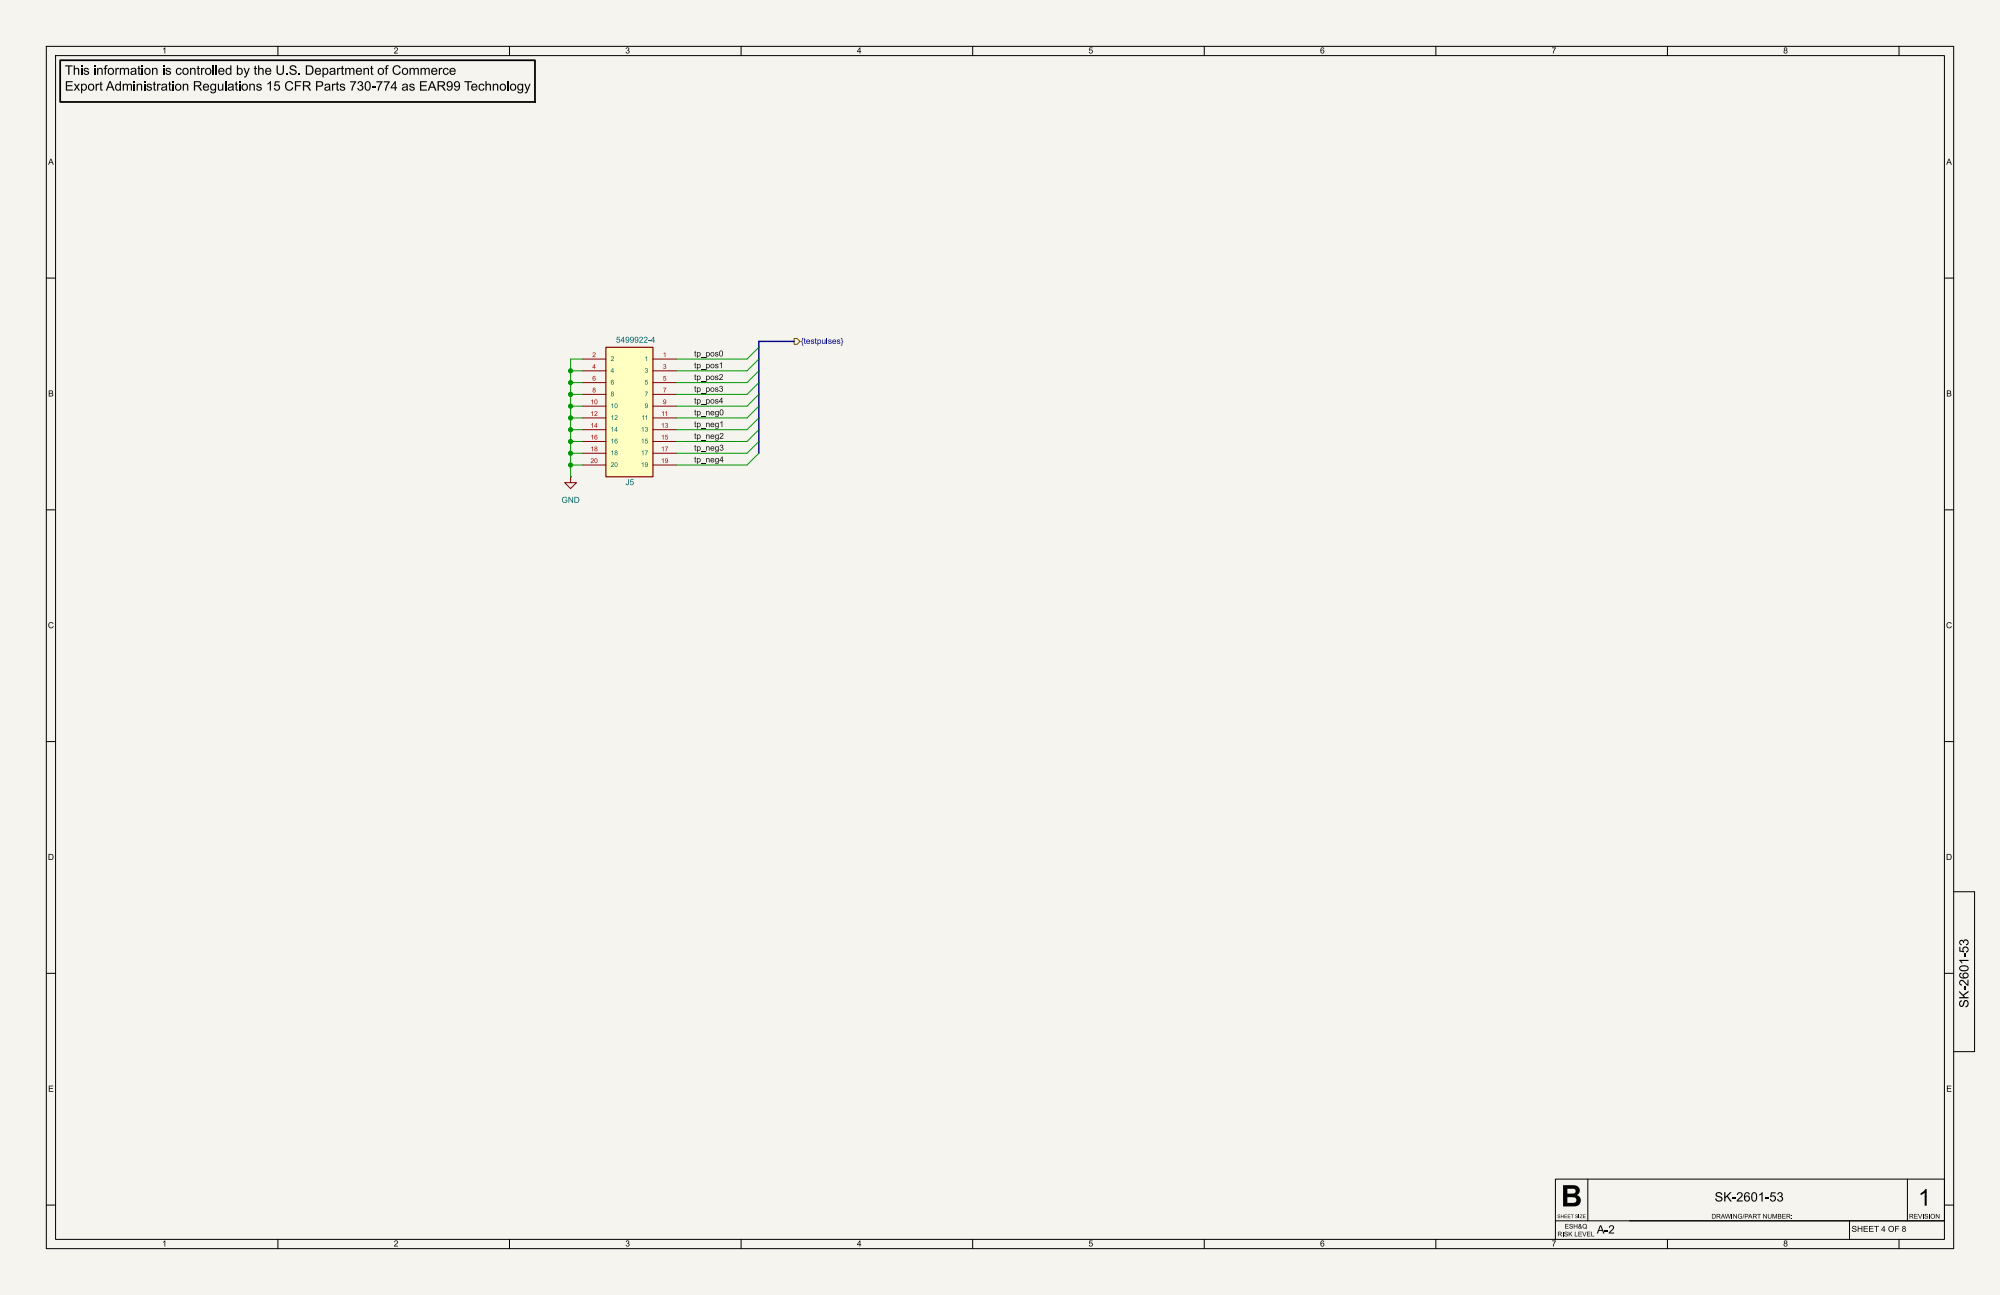
[picture p40: page 4]

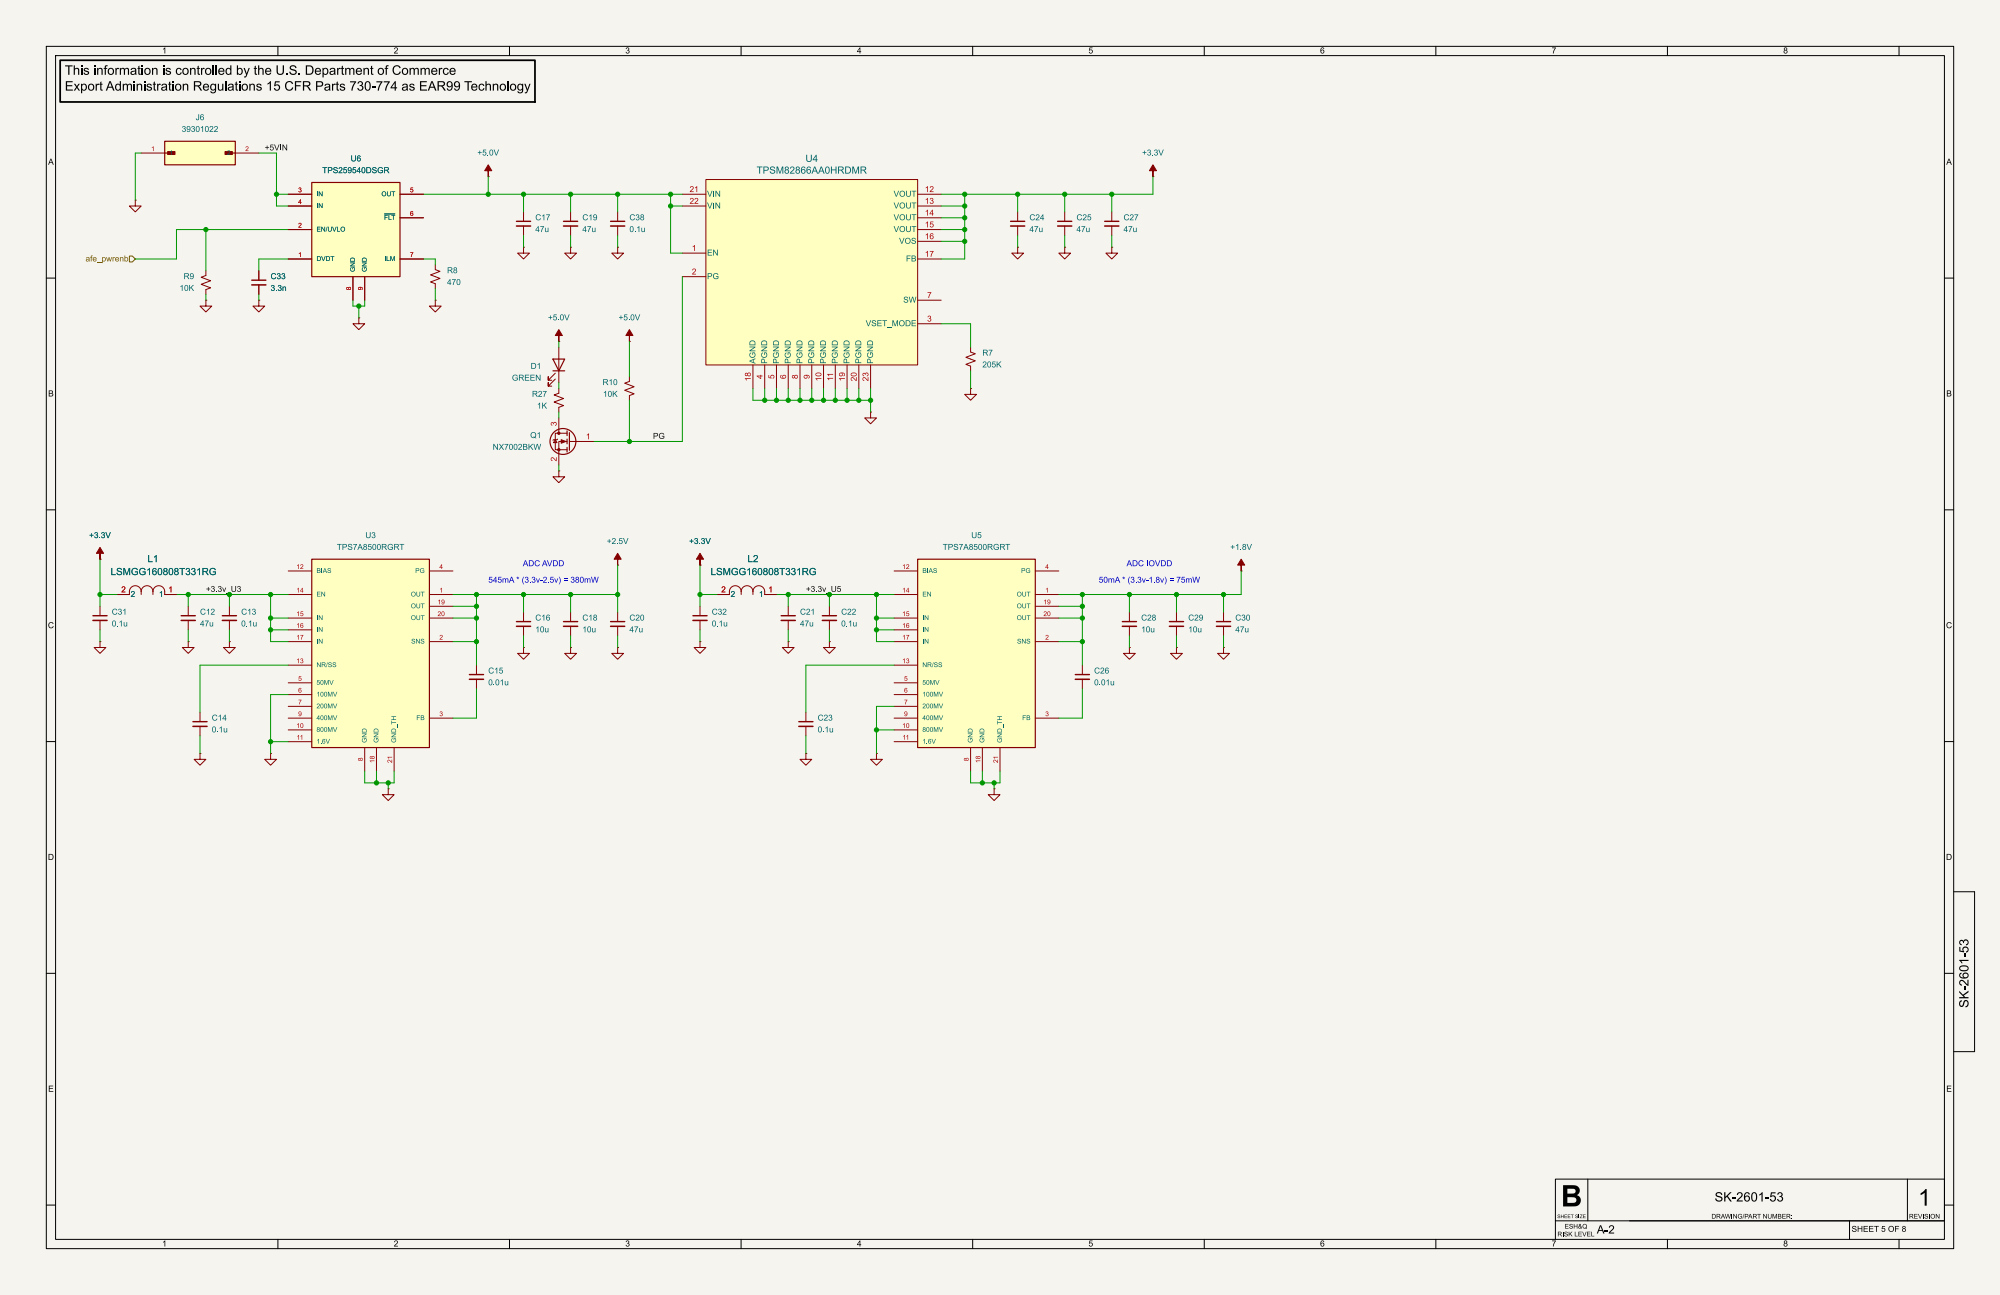
[picture p41: page 5]

9 PGND 10 PGND 11 PGND 19 PGND 20 PGND 23 VOUT 12 VOUT 13 VOUT 14 VOUT 15 VOS 16 FB 17 SW 7 VSET_MODE 3 U4 TPSM82866AA0HRDMR

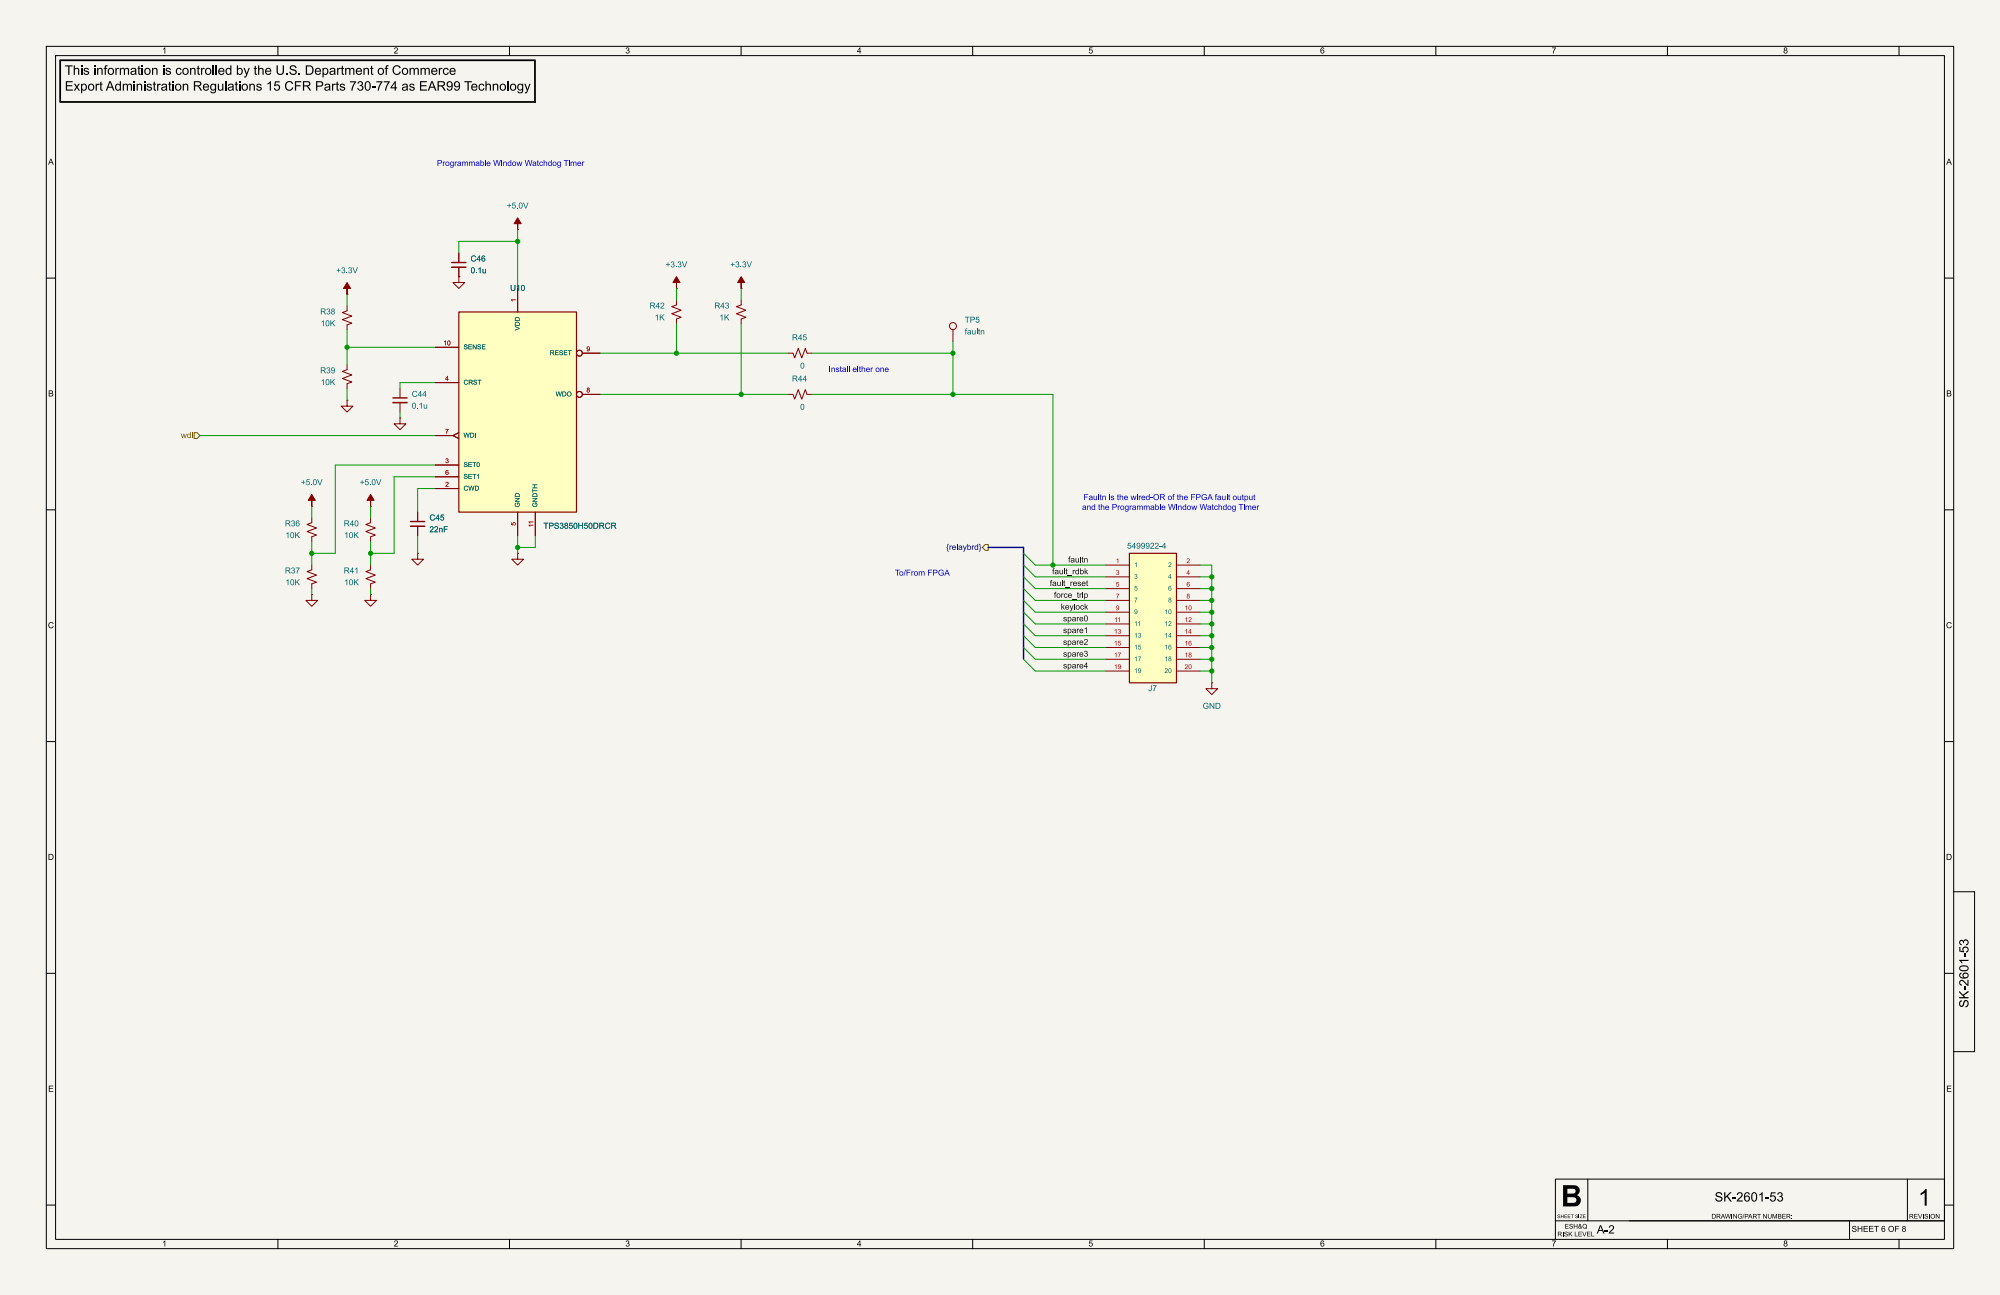
[picture p42: page 6]

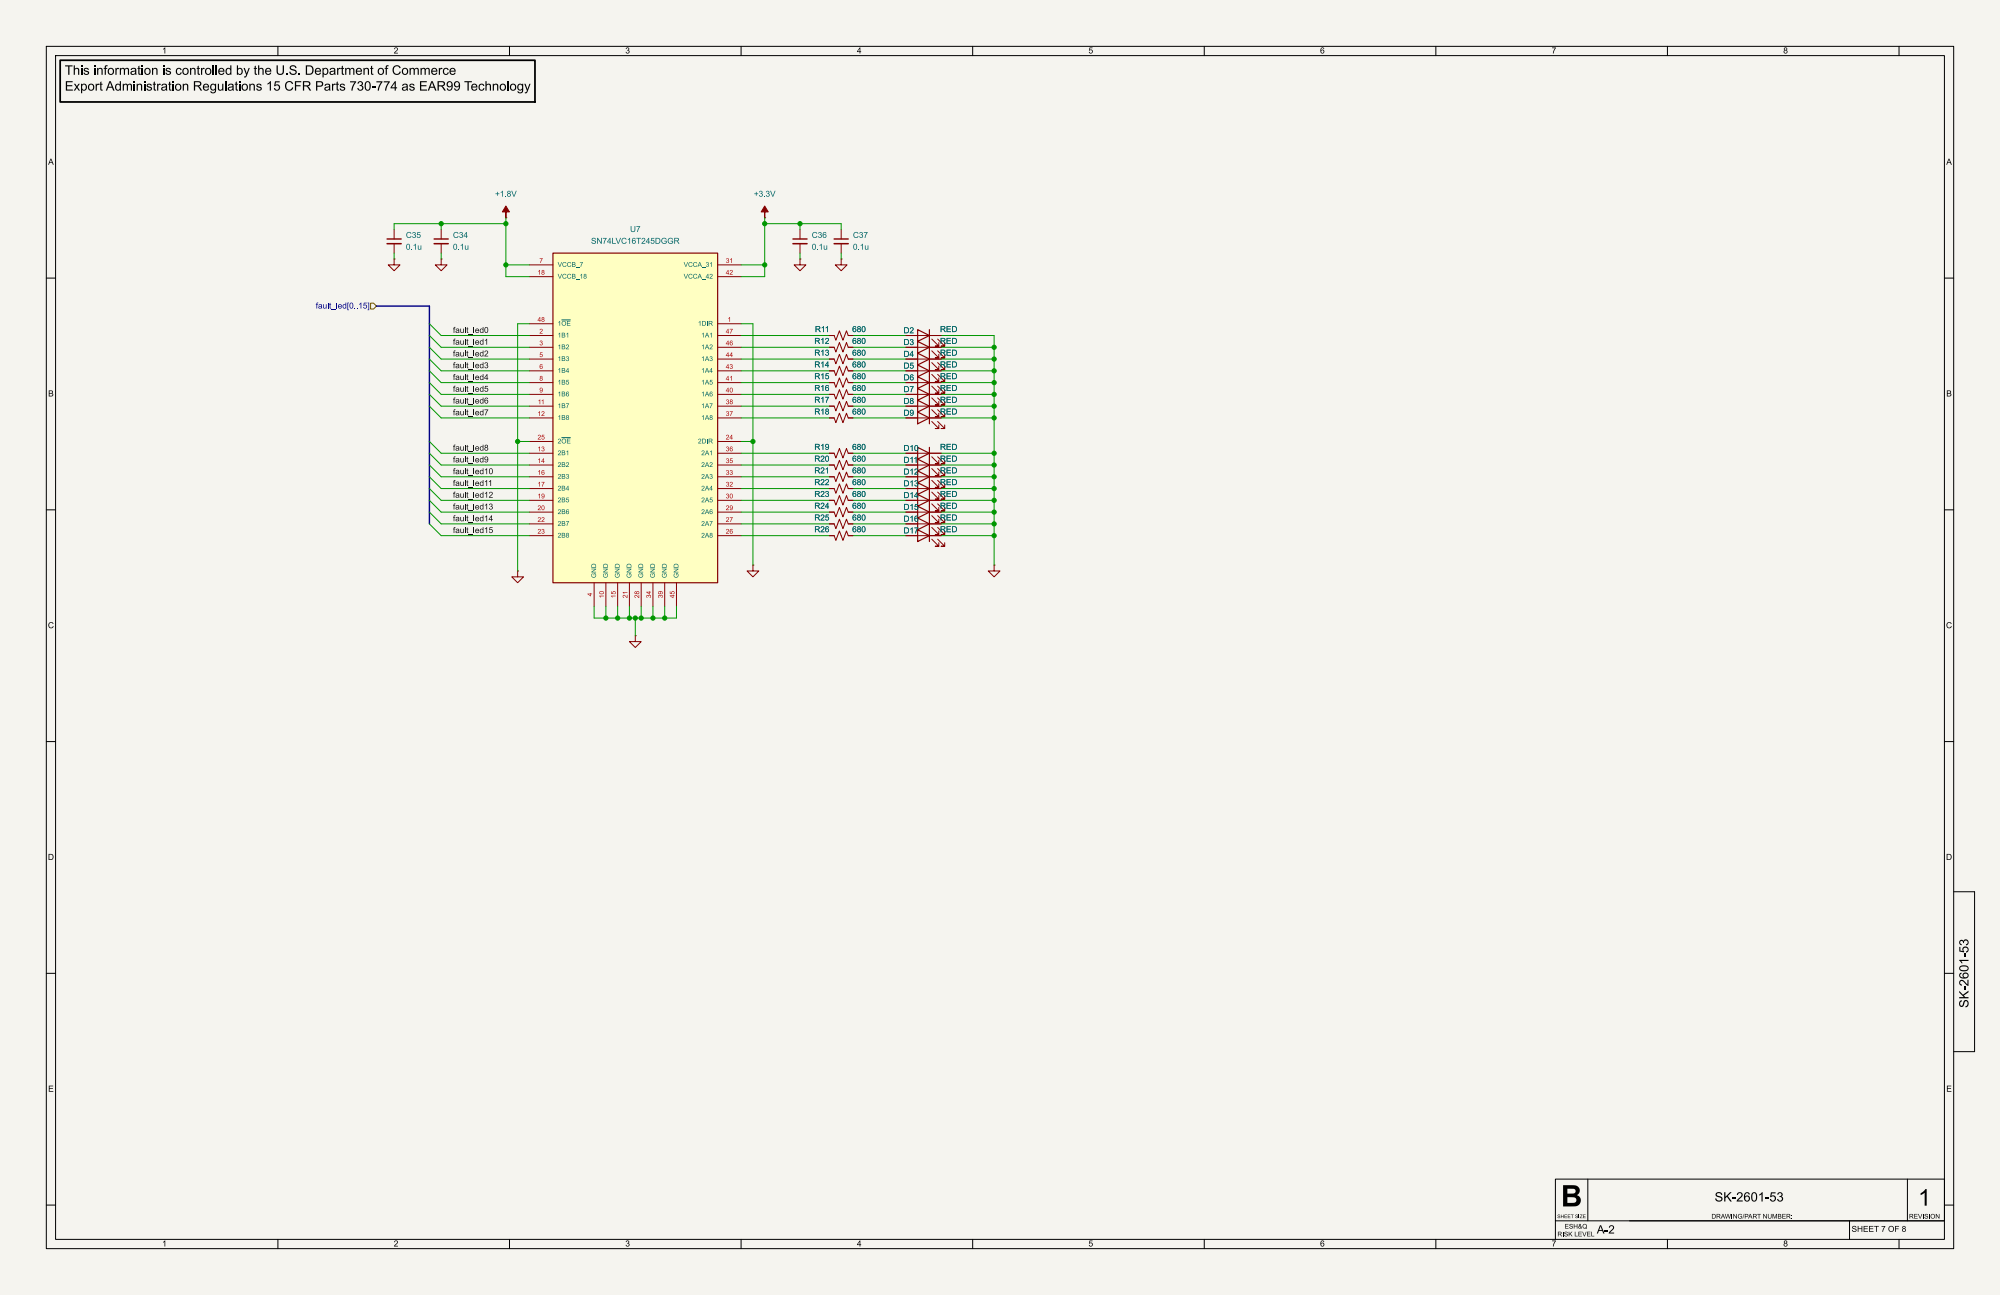
[picture p43: page 7]

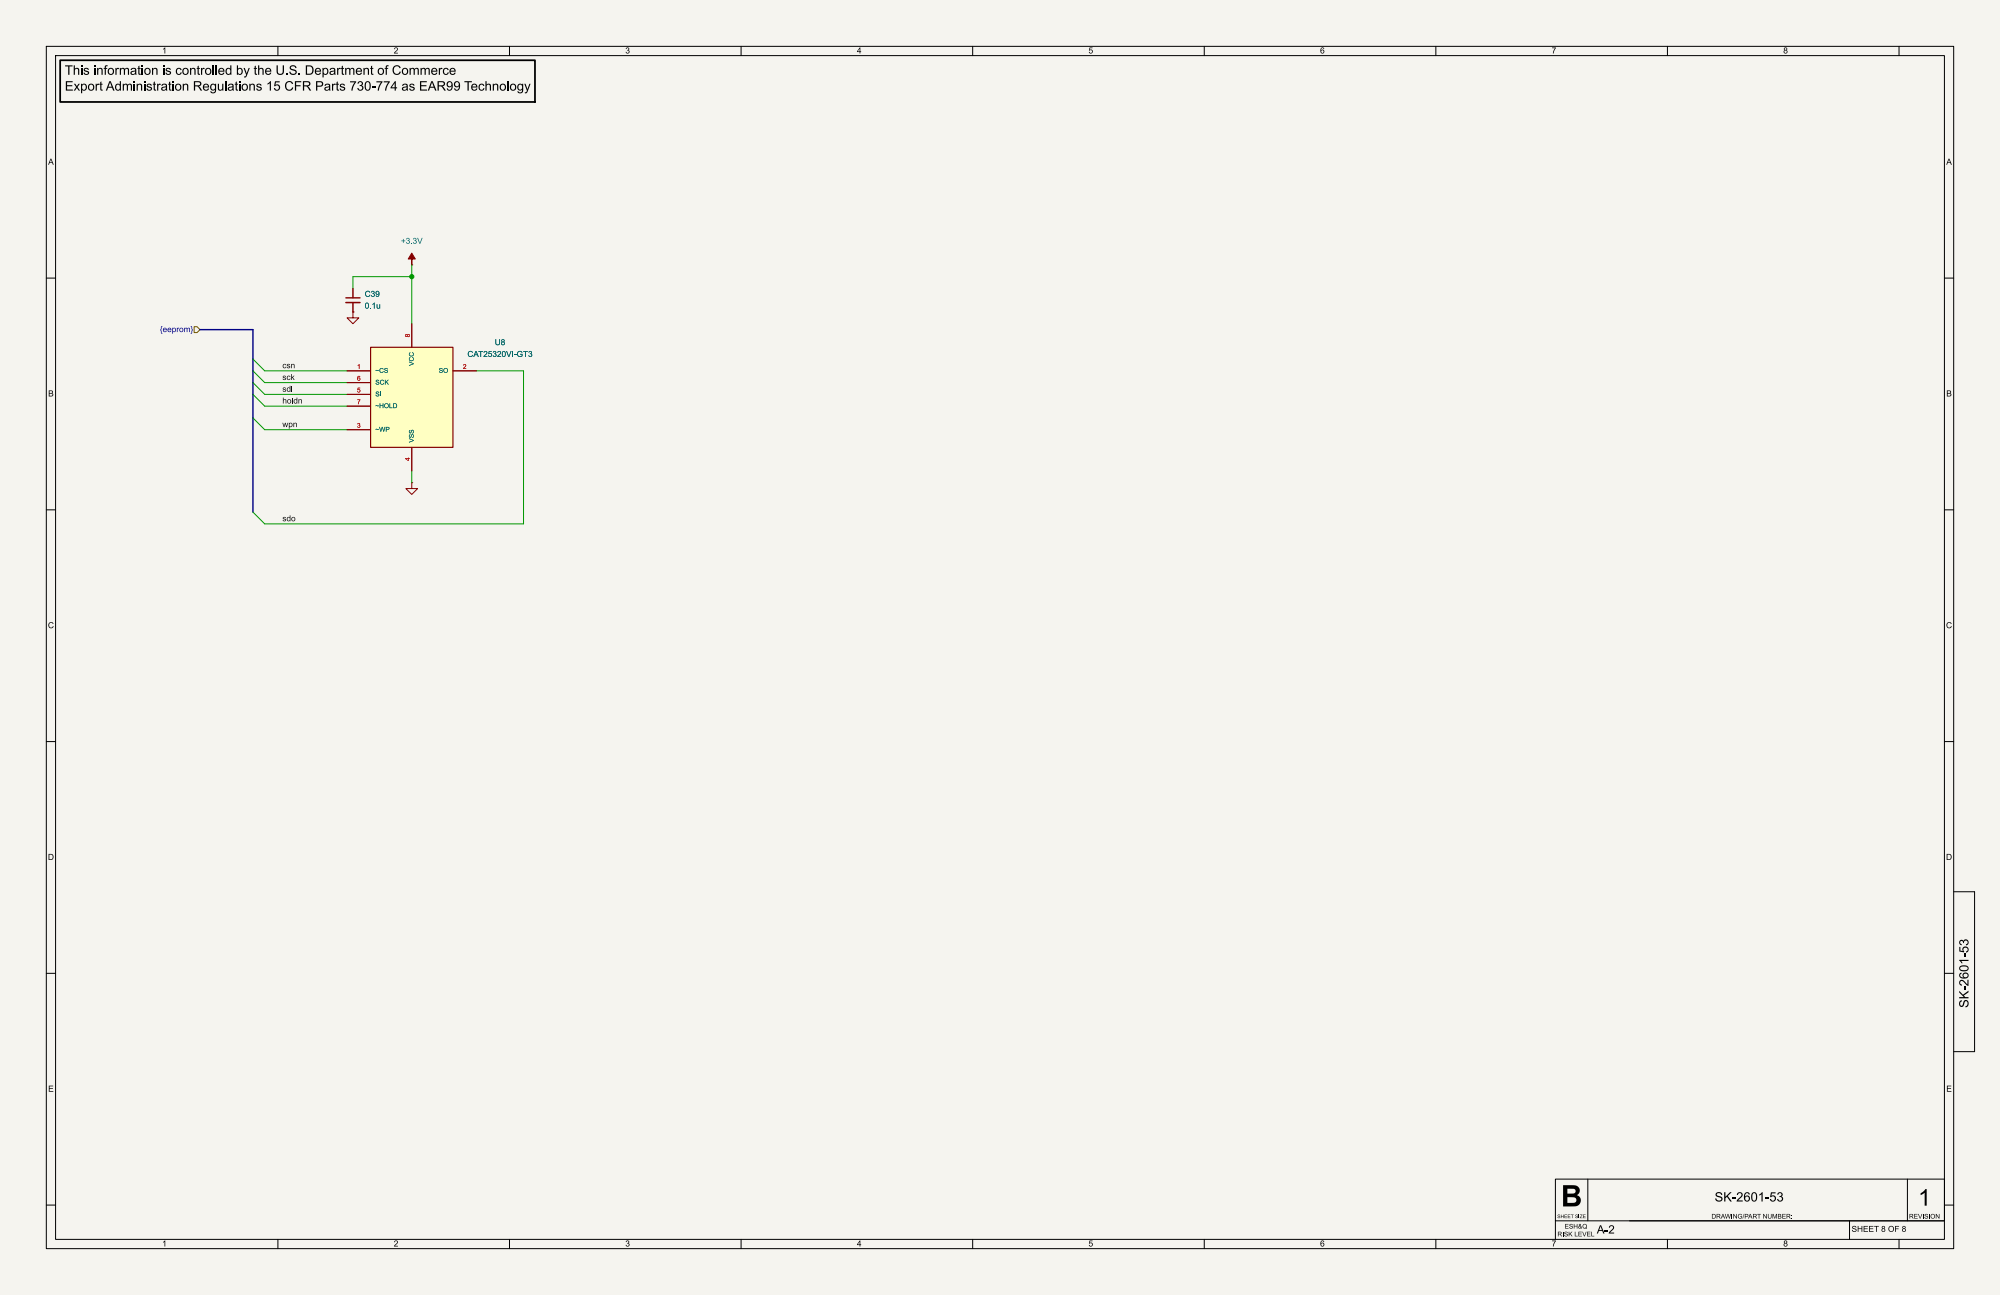
[picture p44: page 8]
