capotostobnl/acmi2-hw-afe/acmi2-afe.kicad_pcb

## KiCad design acmi2-afe.kicad_pcb (2026-06-15)

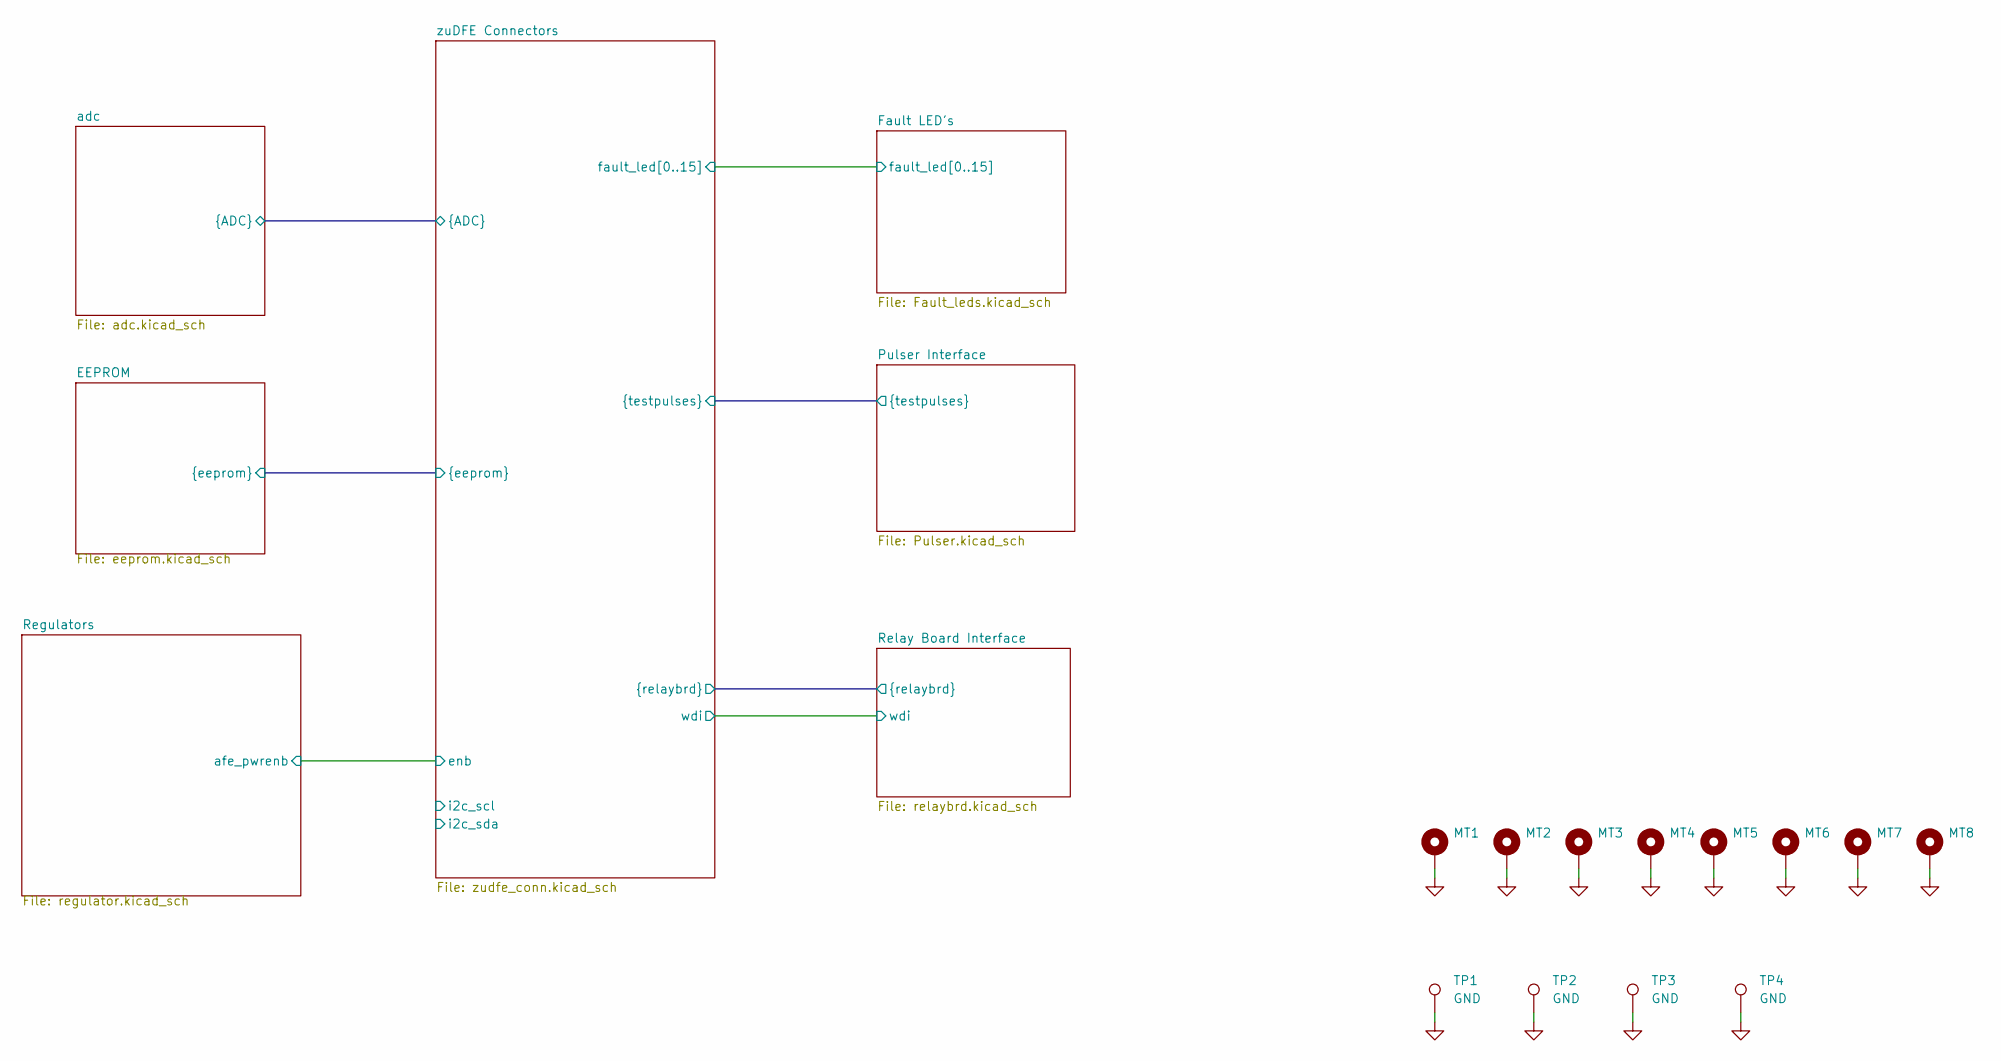
[picture p45: schematic acmi2-afe.kicad_sch]

Parts:
MT1, MT2, MT3, MT4, MT5, MT6, MT7, MT8: MountingHole_Pad; MountingHole_4.3mm_M4_DIN965_Pad
TP1, TP2, TP3, TP4: GND; TestPoint_RCS-0C; MFG_PN RCS-0C

Connections:
GND: MT1.1, MT2.1, MT3.1, MT4.1, MT5.1, MT6.1, MT7.1, MT8.1, TP1.1, TP2.1, TP3.1, TP4.1; also elsewhere on the board

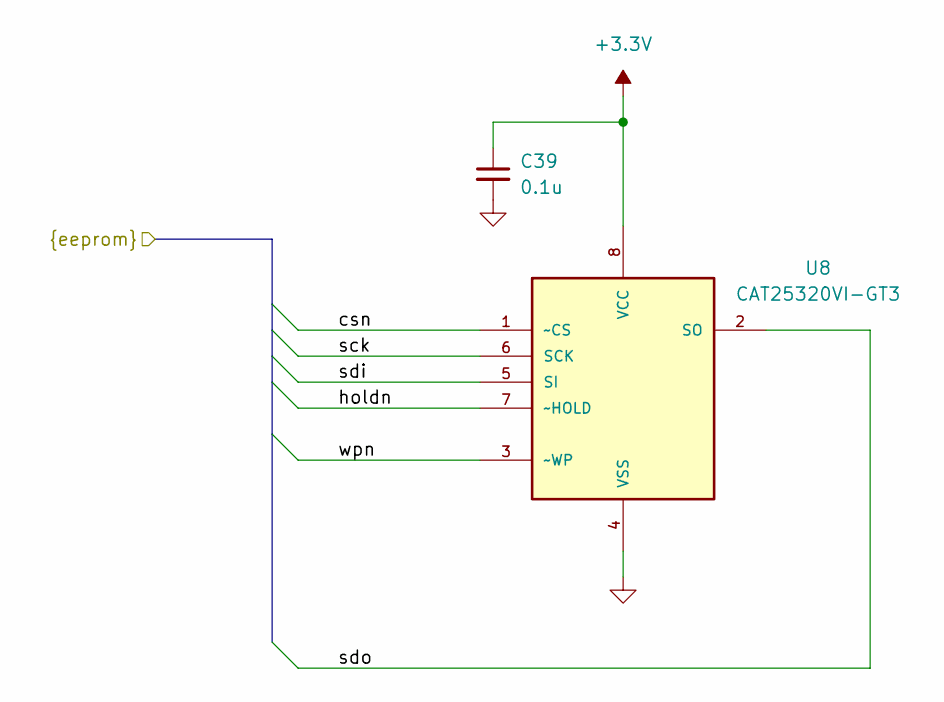
[picture p46: schematic eeprom.kicad_sch]

Parts:
C39: 0.1u; C_0805_2012Metric; MFG_PN TMF212B7104KGHT
U8: CAT25320VI-GT3; SOIC127P600X175-8N; MFG_PN CAT25320VI-GT3

Connections:
+3.3V: C39.1, U8.8 (VCC); also elsewhere on the board
/EEPROM/csn: U8.1 (~CS); also elsewhere on the board
/EEPROM/holdn: U8.7 (~HOLD); also elsewhere on the board
/EEPROM/sck: U8.6 (SCK); also elsewhere on the board
/EEPROM/sdi: U8.5 (SI); also elsewhere on the board
/EEPROM/sdo: U8.2 (SO); also elsewhere on the board
/EEPROM/wpn: U8.3 (~WP); also elsewhere on the board
GND: C39.2, U8.4 (VSS); also elsewhere on the board

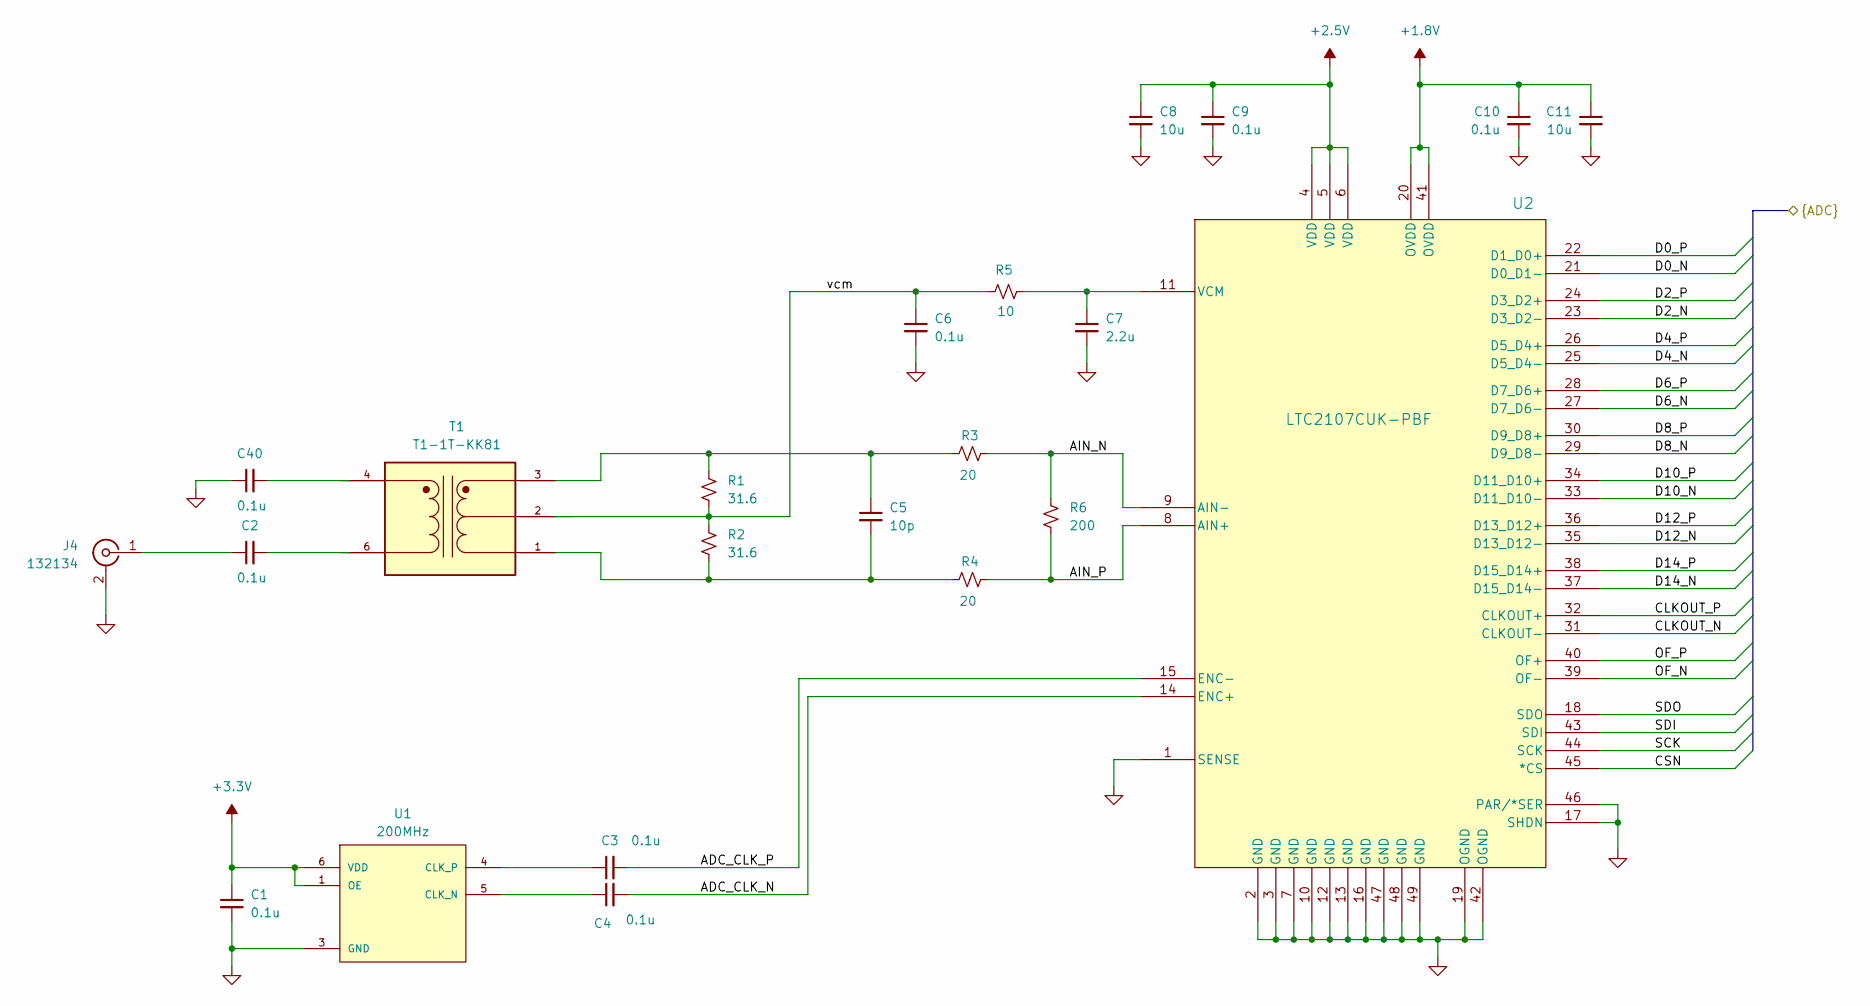
[picture p47: schematic adc.kicad_sch]

Parts:
C1, C2, C3, C4, C6, C9, C10, C40: 0.1u; C_0805_2012Metric; MFG_PN TMF212B7104KGHT
C5: 10p; C_0805_2012Metric; MFG_PN QVS212CG100JDHT
C7: 2.2u; C_0805_2012Metric; MFG_PN UMK212BB7225KG-T
C8, C11: 10u; C_0805_2012Metric; MFG_PN GRM21BR61C106KE15K
J4: 132134; SMA_Amphenol_132134_Vertical; MFG_PN 132134
R1, R2: 31.6; R_0805_2012Metric; MFG_PN ERJ-6ENF31R6V
R3, R4: 20; R_0805_2012Metric; MFG_PN ERJ-6ENF20R0V
R5: 10; R_0805_2012Metric; MFG_PN ERJ-6ENF10R0V
R6: 200; R_0805_2012Metric; MFG_PN ERJ-6ENF2000V
T1: T1-1T-KK81; XFMR_T1-1T-KK81_; PARTREV B
U1: 200MHz; OSC_ECS-LVDS33-2000-BN; MFG_PN ECS-LVDS33-2000-BN
U2: LTC2107CUK-PBF; QFN-48_UK_LIT; MFG_PN LTC2107CUK#PBF

Connections:
+1.8V: C10.1, C11.1, U2.20 (OVDD), U2.41 (OVDD); also elsewhere on the board
+2.5V: C8.1, C9.1, U2.4 (VDD), U2.5 (VDD), U2.6 (VDD); also elsewhere on the board
+3.3V: C1.1, U1.1 (OE), U1.6 (VDD); also elsewhere on the board
/adc/ADC_CLK_N: C4.2, U2.14 (ENC+)
/adc/ADC_CLK_P: C3.2, U2.15 (ENC-)
/adc/AIN_N: R3.1, R6.1, U2.9 (AIN-)
/adc/AIN_P: R4.1, R6.2, U2.8 (AIN+)
/adc/CLKOUT_N: U2.31 (CLKOUT-); also elsewhere on the board
/adc/CLKOUT_P: U2.32 (CLKOUT+); also elsewhere on the board
/adc/CSN: U2.45 (*CS); also elsewhere on the board
/adc/D0_N: U2.21 (D0_D1-); also elsewhere on the board
/adc/D0_P: U2.22 (D1_D0+); also elsewhere on the board
/adc/D2_N: U2.23 (D3_D2-); also elsewhere on the board
/adc/D2_P: U2.24 (D3_D2+); also elsewhere on the board
/adc/D4_N: U2.25 (D5_D4-); also elsewhere on the board
/adc/D4_P: U2.26 (D5_D4+); also elsewhere on the board
/adc/D6_N: U2.27 (D7_D6-); also elsewhere on the board
/adc/D6_P: U2.28 (D7_D6+); also elsewhere on the board
/adc/D8_N: U2.29 (D9_D8-); also elsewhere on the board
/adc/D8_P: U2.30 (D9_D8+); also elsewhere on the board
/adc/D10_N: U2.33 (D11_D10-); also elsewhere on the board
/adc/D10_P: U2.34 (D11_D10+); also elsewhere on the board
/adc/D12_N: U2.35 (D13_D12-); also elsewhere on the board
/adc/D12_P: U2.36 (D13_D12+); also elsewhere on the board
/adc/D14_N: U2.37 (D15_D14-); also elsewhere on the board
/adc/D14_P: U2.38 (D15_D14+); also elsewhere on the board
/adc/OF_N: U2.39 (OF-); also elsewhere on the board
/adc/OF_P: U2.40 (OF+); also elsewhere on the board
/adc/SCK: U2.44 (SCK); also elsewhere on the board
/adc/SDI: U2.43 (SDI); also elsewhere on the board
/adc/SDO: U2.18 (SDO); also elsewhere on the board
/adc/vcm: C6.1, R1.2, R2.1, R5.2, T1.2
GND: C1.2, C6.2, C7.2, C8.2, C9.2, C10.2, C11.2, C40.1, J4.2 (Ext), U1.3 (GND), U2.1 (SENSE), U2.2 (GND), U2.3 (GND), U2.7 (GND), U2.10 (GND), U2.12 (GND), U2.13 (GND), U2.16 (GND), U2.17 (SHDN), U2.19 (OGND), U2.42 (OGND), U2.46 (PAR/*SER), U2.47 (GND), U2.48 (GND), U2.49 (GND); also elsewhere on the board
unnamed: C2.2, T1.6
unnamed: C5.1, R1.1, R3.2, T1.3
unnamed: C5.2, R2.2, R4.2, T1.1
unnamed: C40.2, T1.4
unnamed: C2.1, J4.1 (In)
unnamed: C4.1, U1.5 (CLK_N)
unnamed: C3.1, U1.4 (CLK_P)
unnamed: C7.1, R5.1, U2.11 (VCM)

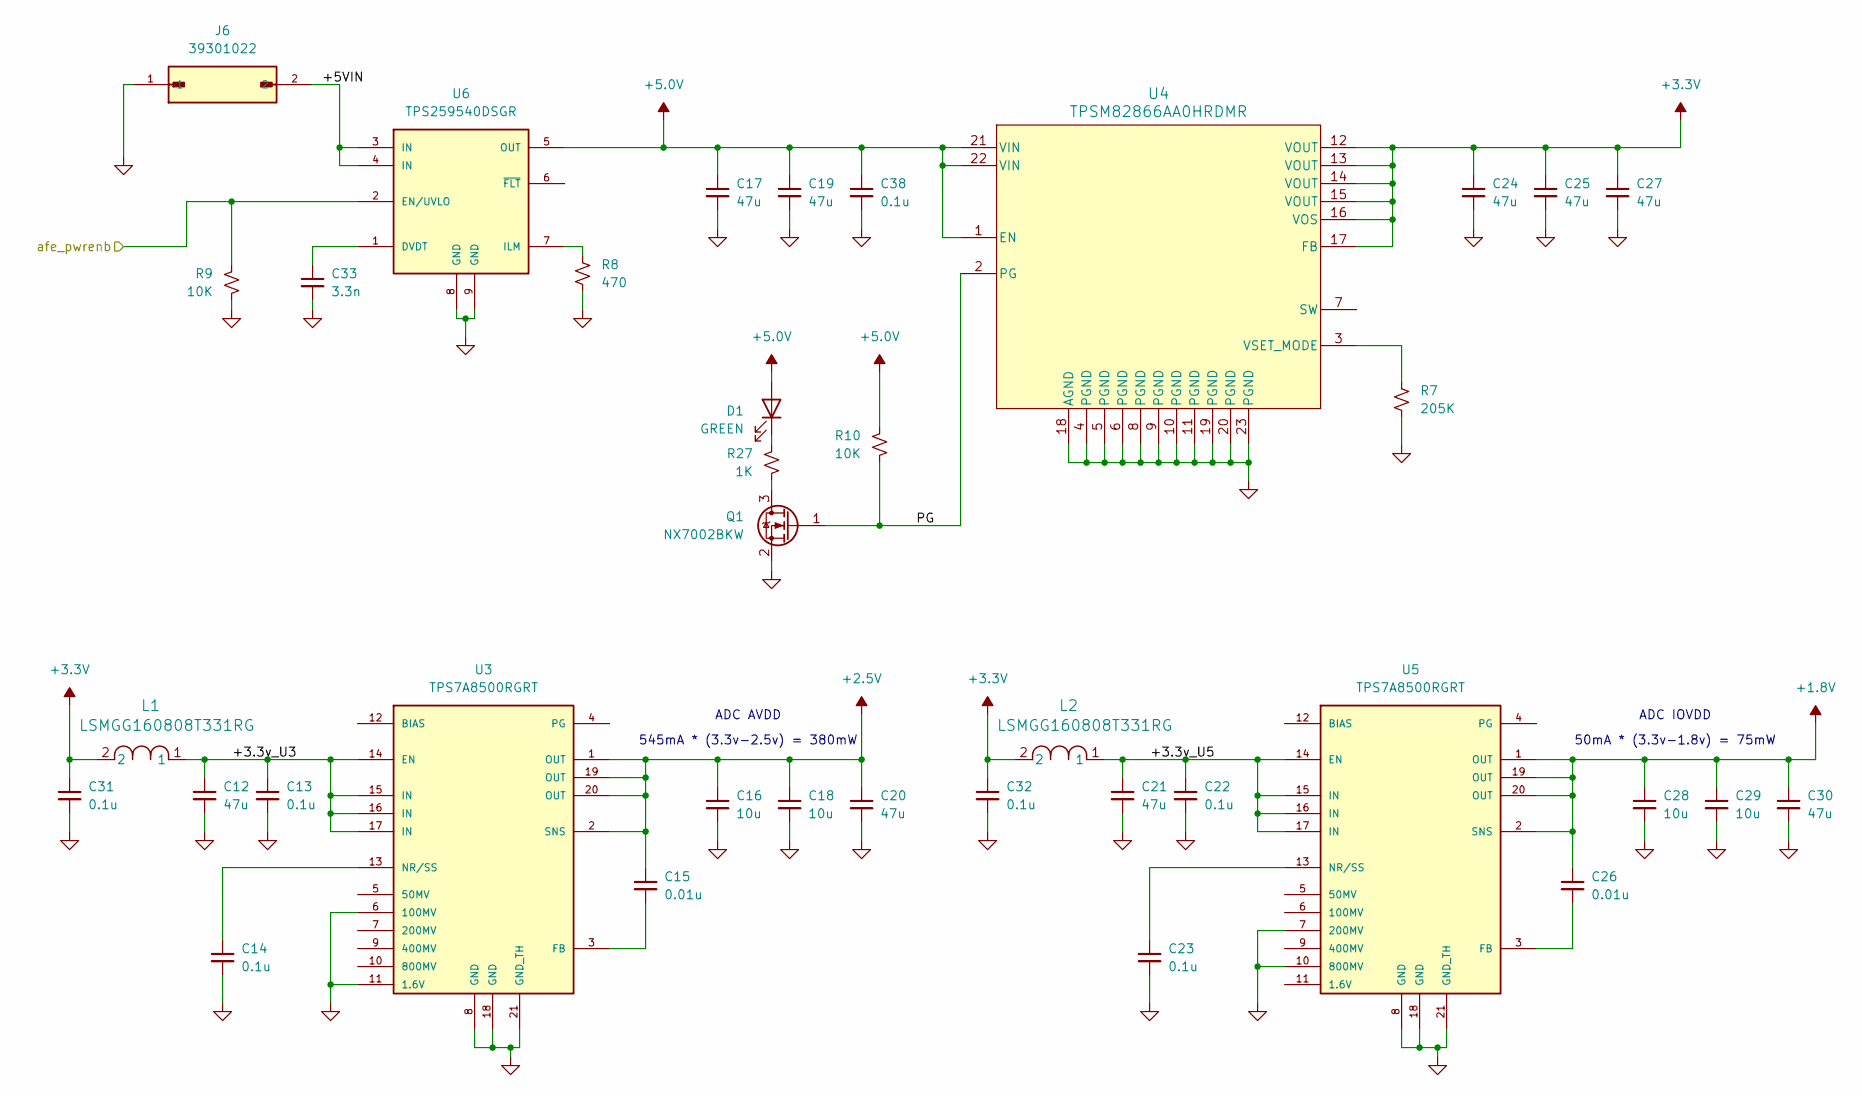
[picture p48: schematic regulator.kicad_sch]

Parts:
C12, C17, C19, C20, C21, C24, C25, C27, C30: 47u; C_0805_2012Metric; MFG_PN C2012X5R1A476M125AC
C13, C14, C22, C23, C31, C32, C38: 0.1u; C_0805_2012Metric; MFG_PN TMF212B7104KGHT
C15, C26: 0.01u; C_0805_2012Metric; MFG_PN MAASU21GSL8103MTNA01
C16, C18, C28, C29: 10u; C_0805_2012Metric; MFG_PN GRM21BR61C106KE15K
C33: 3.3n; C_0805_2012Metric; MFG_PN C0805X332K5RECTU
D1: GREEN; LED_0805_2012Metric; MFG_PN LTST-C191KGKT
J6: 39301022; MOLEX_39301022; PARTREV A
L1, L2: LSMGG160808T331RG; IND_LSMG_160808_TAY; MFG_PN LSMGG160808T331RG
Q1: NX7002BKW; SOT-323_SC-70; MFG_PN NX7002BKWX
R7: 205K; R_0805_2012Metric; MFG_PN ERJ-6ENF2053V
R8: 470; R_0805_2012Metric; MFG_PN ERJ-6ENF4700V
R9, R10: 10K; R_0805_2012Metric; MFG_PN ERJ-2RKF1001X
R27: 1K; R_0805_2012Metric; MFG_PN ERJ-P06F1001V
U3, U5: TPS7A8500RGRT; QFN50P350X350X100-21N; MFG_PN TPS7A8500RGRT
U4: TPSM82866AA0HRDMR; RDM0023A-MFG; MFG_PN TPSM82866AA0HRDMR
U6: TPS259540DSGR; SON50P200X200X80-9N; MFG_PN TPS259540DSGR

Connections:
+1.8V: C26.1, C28.1, C29.1, C30.1, U5.1 (OUT), U5.2 (SNS), U5.19 (OUT), U5.20 (OUT); also elsewhere on the board
+2.5V: C15.1, C16.1, C18.1, C20.1, U3.1 (OUT), U3.2 (SNS), U3.19 (OUT), U3.20 (OUT); also elsewhere on the board
+3.3V: C24.1, C25.1, C27.1, C31.1, C32.1, L1.2, L2.2, U4.12 (VOUT), U4.13 (VOUT), U4.14 (VOUT), U4.15 (VOUT), U4.16 (VOS), U4.17 (FB); also elsewhere on the board
+5.0V: C17.1, C19.1, C38.1, D1.2 (A), R10.1, U4.1 (EN), U4.21 (VIN), U4.22 (VIN), U6.5 (OUT); also elsewhere on the board
/Regulators/+3.3v_U3: C12.1, C13.1, L1.1, U3.14 (EN), U3.15 (IN), U3.16 (IN), U3.17 (IN)
/Regulators/+3.3v_U5: C21.1, C22.1, L2.1, U5.14 (EN), U5.15 (IN), U5.16 (IN), U5.17 (IN)
/Regulators/+5VIN: J6.2, U6.3 (IN), U6.4 (IN)
/Regulators/PG: Q1.1 (G), R10.2, U4.2 (PG)
/Regulators/afe_pwrenb: R9.1, U6.2 (EN/UVLO); also elsewhere on the board
GND: C12.2, C13.2, C14.2, C16.2, C17.2, C18.2, C19.2, C20.2, C21.2, C22.2, C23.2, C24.2, C25.2, C27.2, C28.2, C29.2, C30.2, C31.2, C32.2, C33.2, C38.2, J6.1, Q1.2 (S), R7.2, R8.2, R9.2, U3.6 (100MV), U3.8 (GND), U3.11 (1.6V), U3.18 (GND), U3.21 (GND_TH), U4.4 (PGND), U4.5 (PGND), U4.6 (PGND), U4.8 (PGND), U4.9 (PGND), U4.10 (PGND), U4.11 (PGND), U4.18 (AGND), U4.19 (PGND), U4.20 (PGND), U4.23 (PGND), U5.7 (200MV), U5.8 (GND), U5.10 (800MV), U5.18 (GND), U5.21 (GND_TH), U6.8 (GND), U6.9 (GND); also elsewhere on the board
unnamed: D1.1 (K), R27.1
unnamed: Q1.3 (D), R27.2
unnamed: C15.2, U3.3 (FB)
unnamed: C14.1, U3.13 (NR/SS)
unnamed: R7.1, U4.3 (VSET_MODE)
unnamed: C26.2, U5.3 (FB)
unnamed: C23.1, U5.13 (NR/SS)
unnamed: C33.1, U6.1 (DVDT)
unnamed: R8.1, U6.7 (ILM)

Notes on the sheet:
50mA * (3.3v-1.8v) = 75mW
ADC IOVDD
ADC AVDD
545mA * (3.3v-2.5v) = 380mW

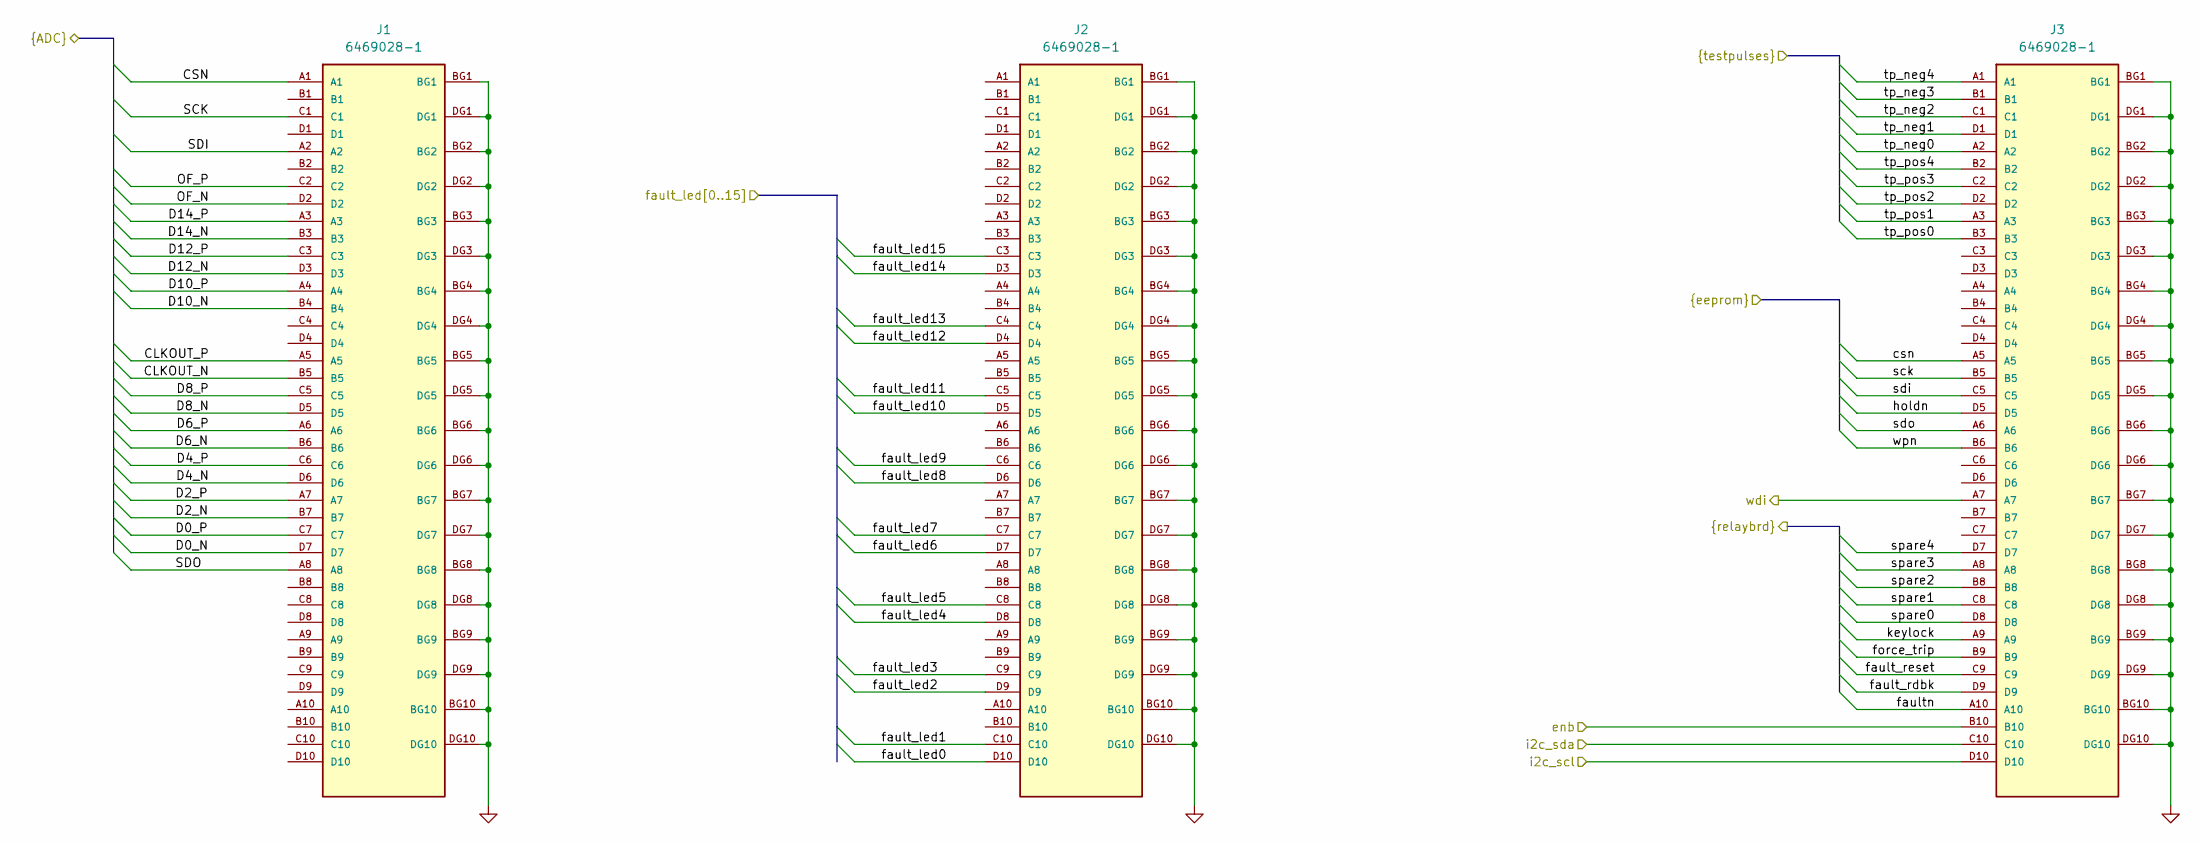
[picture p49: schematic zudfe_conn.kicad_sch]

Parts:
J1, J2, J3: 6469028-1; TE_6469028-1; PARTREV E

Connections:
/EEPROM/csn: J3.A5; also elsewhere on the board
/EEPROM/holdn: J3.D5; also elsewhere on the board
/EEPROM/sck: J3.B5; also elsewhere on the board
/EEPROM/sdi: J3.C5; also elsewhere on the board
/EEPROM/sdo: J3.A6; also elsewhere on the board
/EEPROM/wpn: J3.B6; also elsewhere on the board
/Fault LED's/fault_led0: J2.D10; also elsewhere on the board
/Fault LED's/fault_led1: J2.C10; also elsewhere on the board
/Fault LED's/fault_led2: J2.D9; also elsewhere on the board
/Fault LED's/fault_led3: J2.C9; also elsewhere on the board
/Fault LED's/fault_led4: J2.D8; also elsewhere on the board
/Fault LED's/fault_led5: J2.C8; also elsewhere on the board
/Fault LED's/fault_led6: J2.D7; also elsewhere on the board
/Fault LED's/fault_led7: J2.C7; also elsewhere on the board
/Fault LED's/fault_led8: J2.D6; also elsewhere on the board
/Fault LED's/fault_led9: J2.C6; also elsewhere on the board
/Fault LED's/fault_led10: J2.D5; also elsewhere on the board
/Fault LED's/fault_led11: J2.C5; also elsewhere on the board
/Fault LED's/fault_led12: J2.D4; also elsewhere on the board
/Fault LED's/fault_led13: J2.C4; also elsewhere on the board
/Fault LED's/fault_led14: J2.D3; also elsewhere on the board
/Fault LED's/fault_led15: J2.C3; also elsewhere on the board
/Pulser Interface/tp_neg0: J3.A2; also elsewhere on the board
/Pulser Interface/tp_neg1: J3.D1; also elsewhere on the board
/Pulser Interface/tp_neg2: J3.C1; also elsewhere on the board
/Pulser Interface/tp_neg3: J3.B1; also elsewhere on the board
/Pulser Interface/tp_neg4: J3.A1; also elsewhere on the board
/Pulser Interface/tp_pos0: J3.B3; also elsewhere on the board
/Pulser Interface/tp_pos1: J3.A3; also elsewhere on the board
/Pulser Interface/tp_pos2: J3.D2; also elsewhere on the board
/Pulser Interface/tp_pos3: J3.C2; also elsewhere on the board
/Pulser Interface/tp_pos4: J3.B2; also elsewhere on the board
/Regulators/afe_pwrenb: J3.B10; also elsewhere on the board
/Relay Board Interface/fault_rdbk: J3.D9; also elsewhere on the board
/Relay Board Interface/fault_reset: J3.C9; also elsewhere on the board
/Relay Board Interface/faultn: J3.A10; also elsewhere on the board
/Relay Board Interface/force_trip: J3.B9; also elsewhere on the board
/Relay Board Interface/keylock: J3.A9; also elsewhere on the board
/Relay Board Interface/spare0: J3.D8; also elsewhere on the board
/Relay Board Interface/spare1: J3.C8; also elsewhere on the board
/Relay Board Interface/spare2: J3.B8; also elsewhere on the board
/Relay Board Interface/spare3: J3.A8; also elsewhere on the board
/Relay Board Interface/spare4: J3.D7; also elsewhere on the board
/Relay Board Interface/wdi: J3.A7; also elsewhere on the board
/adc/CLKOUT_N: J1.B5; also elsewhere on the board
/adc/CLKOUT_P: J1.A5; also elsewhere on the board
/adc/CSN: J1.A1; also elsewhere on the board
/adc/D0_N: J1.D7; also elsewhere on the board
/adc/D0_P: J1.C7; also elsewhere on the board
/adc/D2_N: J1.B7; also elsewhere on the board
/adc/D2_P: J1.A7; also elsewhere on the board
/adc/D4_N: J1.D6; also elsewhere on the board
/adc/D4_P: J1.C6; also elsewhere on the board
/adc/D6_N: J1.B6; also elsewhere on the board
/adc/D6_P: J1.A6; also elsewhere on the board
/adc/D8_N: J1.D5; also elsewhere on the board
/adc/D8_P: J1.C5; also elsewhere on the board
/adc/D10_N: J1.B4; also elsewhere on the board
/adc/D10_P: J1.A4; also elsewhere on the board
/adc/D12_N: J1.D3; also elsewhere on the board
/adc/D12_P: J1.C3; also elsewhere on the board
/adc/D14_N: J1.B3; also elsewhere on the board
/adc/D14_P: J1.A3; also elsewhere on the board
/adc/OF_N: J1.D2; also elsewhere on the board
/adc/OF_P: J1.C2; also elsewhere on the board
/adc/SCK: J1.C1; also elsewhere on the board
/adc/SDI: J1.A2; also elsewhere on the board
/adc/SDO: J1.A8; also elsewhere on the board
/zuDFE Connectors/i2c_scl: J3.D10
/zuDFE Connectors/i2c_sda: J3.C10
GND: J1.BG1, J1.BG2, J1.BG3, J1.BG4, J1.BG5, J1.BG6, J1.BG7, J1.BG8, J1.BG9, J1.BG10, J1.DG1, J1.DG2, J1.DG3, J1.DG4, J1.DG5, J1.DG6, J1.DG7, J1.DG8, J1.DG9, J1.DG10, J2.BG1, J2.BG2, J2.BG3, J2.BG4, J2.BG5, J2.BG6, J2.BG7, J2.BG8, J2.BG9, J2.BG10, J2.DG1, J2.DG2, J2.DG3, J2.DG4, J2.DG5, J2.DG6, J2.DG7, J2.DG8, J2.DG9, J2.DG10, J3.BG1, J3.BG2, J3.BG3, J3.BG4, J3.BG5, J3.BG6, J3.BG7, J3.BG8, J3.BG9, J3.BG10, J3.DG1, J3.DG2, J3.DG3, J3.DG4, J3.DG5, J3.DG6, J3.DG7, J3.DG8, J3.DG9, J3.DG10; also elsewhere on the board

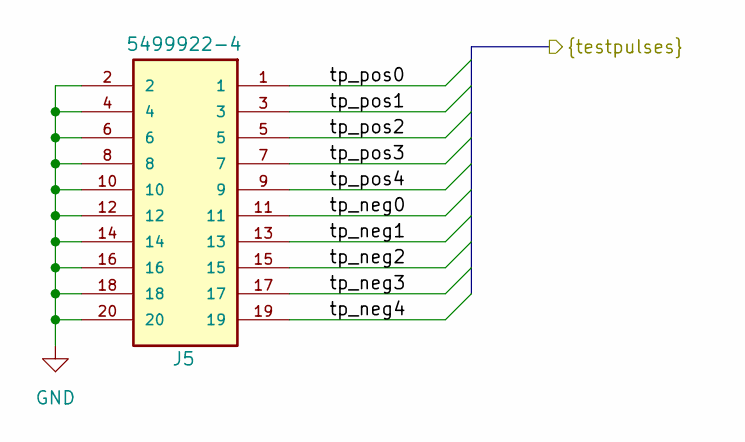
[picture p50: schematic Pulser.kicad_sch]

Parts:
J5: 5499922-4; TE_5499922-4; PARTREV R

Connections:
/Pulser Interface/tp_neg0: J5.11; also elsewhere on the board
/Pulser Interface/tp_neg1: J5.13; also elsewhere on the board
/Pulser Interface/tp_neg2: J5.15; also elsewhere on the board
/Pulser Interface/tp_neg3: J5.17; also elsewhere on the board
/Pulser Interface/tp_neg4: J5.19; also elsewhere on the board
/Pulser Interface/tp_pos0: J5.1; also elsewhere on the board
/Pulser Interface/tp_pos1: J5.3; also elsewhere on the board
/Pulser Interface/tp_pos2: J5.5; also elsewhere on the board
/Pulser Interface/tp_pos3: J5.7; also elsewhere on the board
/Pulser Interface/tp_pos4: J5.9; also elsewhere on the board
GND: J5.2, J5.4, J5.6, J5.8, J5.10, J5.12, J5.14, J5.16, J5.18, J5.20; also elsewhere on the board

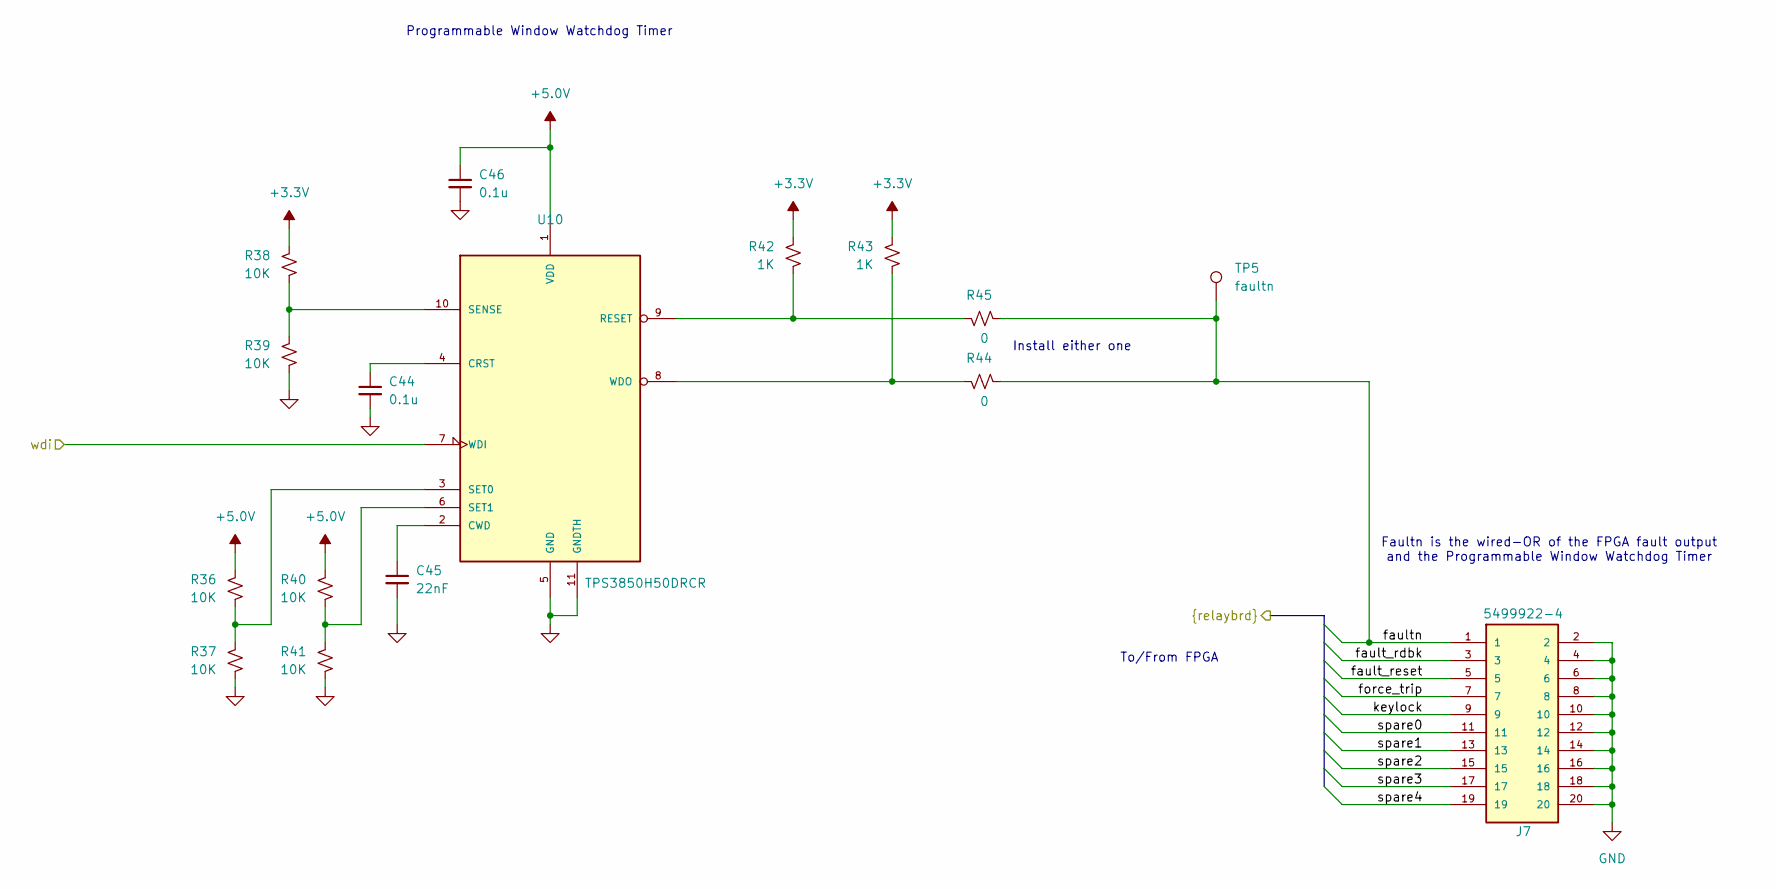
[picture p51: schematic relaybrd.kicad_sch]

Parts:
C44, C46: 0.1u; C_0805_2012Metric; MFG_PN TMF212B7104KGHT
C45: 22nF; C_0805_2012Metric; MFG_PN C0805C223J3GEC7210
J7: 5499922-4; TE_5499922-4; PARTREV R
R36, R37, R38, R39, R40, R41: 10K; R_0805_2012Metric; MFG_PN ERJ-2RKF1001X
R42, R43: 1K; R_0805_2012Metric; MFG_PN ERJ-P06F1001V
R44, R45: 0; R_0805_2012Metric; MFG_PN ERJ-2RKF1001X
TP5: faultn; TestPoint_RCS-0C; MFG_PN RCS-0C
U10: TPS3850H50DRCR; TPS3850_DRCR; MFG_PN TPS3850H33DRCR

Connections:
+3.3V: R38.1, R42.1, R43.1; also elsewhere on the board
+5.0V: C46.1, R36.1, R40.1, U10.1 (VDD); also elsewhere on the board
/Relay Board Interface/fault_rdbk: J7.3; also elsewhere on the board
/Relay Board Interface/fault_reset: J7.5; also elsewhere on the board
/Relay Board Interface/faultn: J7.1, R44.2, R45.2, TP5.1; also elsewhere on the board
/Relay Board Interface/force_trip: J7.7; also elsewhere on the board
/Relay Board Interface/keylock: J7.9; also elsewhere on the board
/Relay Board Interface/spare0: J7.11; also elsewhere on the board
/Relay Board Interface/spare1: J7.13; also elsewhere on the board
/Relay Board Interface/spare2: J7.15; also elsewhere on the board
/Relay Board Interface/spare3: J7.17; also elsewhere on the board
/Relay Board Interface/spare4: J7.19; also elsewhere on the board
/Relay Board Interface/wdi: U10.7 (WDI); also elsewhere on the board
GND: C44.2, C45.2, C46.2, J7.2, J7.4, J7.6, J7.8, J7.10, J7.12, J7.14, J7.16, J7.18, J7.20, R37.2, R39.2, R41.2, U10.5 (GND), U10.11 (GNDTH); also elsewhere on the board
unnamed: C44.1, U10.4 (CRST)
unnamed: C45.1, U10.2 (CWD)
unnamed: R42.2, R45.1, U10.9 (RESET)
unnamed: R38.2, R39.1, U10.10 (SENSE)
unnamed: R36.2, R37.1, U10.3 (SET0)
unnamed: R40.2, R41.1, U10.6 (SET1)
unnamed: R43.2, R44.1, U10.8 (WDO)

Notes on the sheet:
To/From FPGA
Faultn is the wired-OR of the FPGA fault output and the Programmable Window Watchdog Timer
Install either one
Programmable Window Watchdog Timer

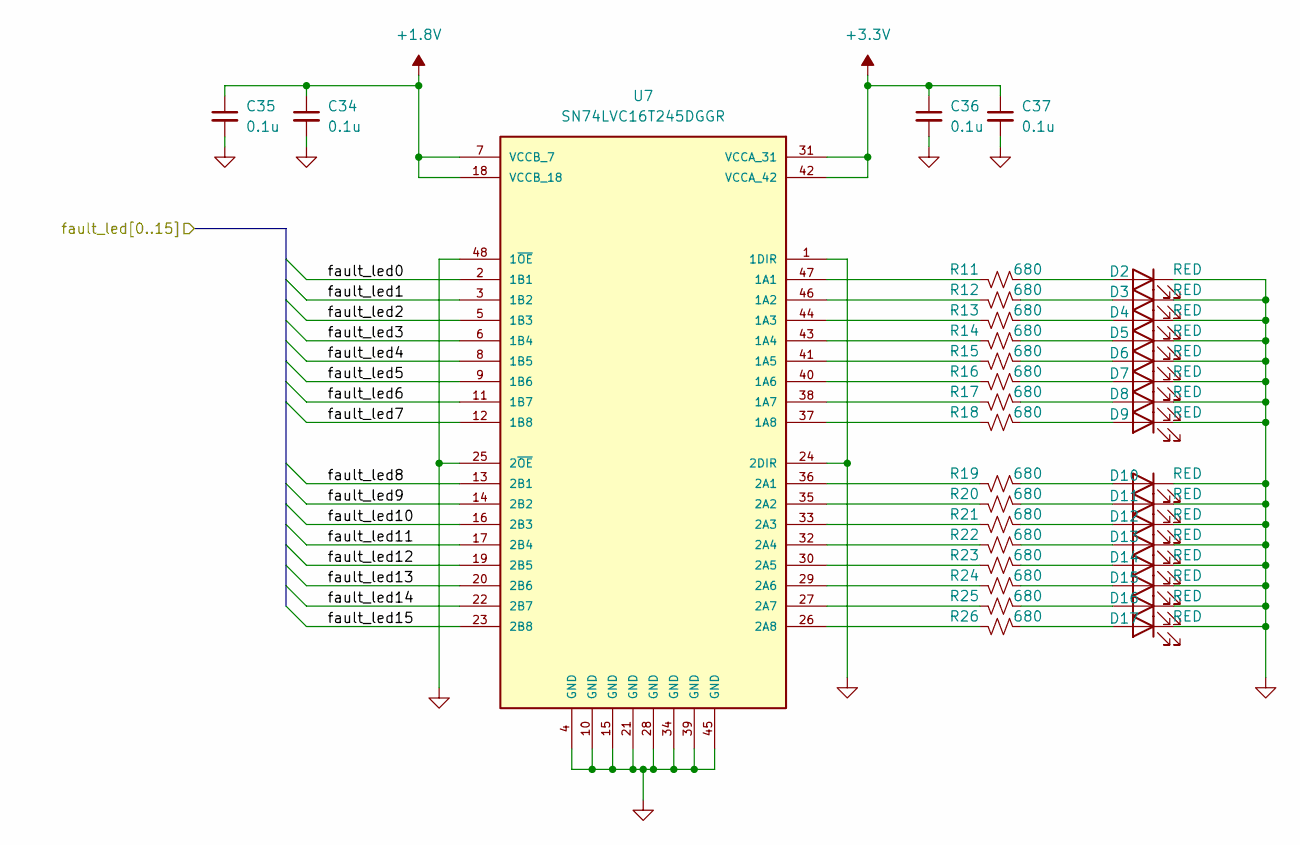
[picture p52: schematic Fault_leds.kicad_sch]

Parts:
C34, C35, C36, C37: 0.1u; C_0805_2012Metric; MFG_PN TMF212B7104KGHT
D2, D3, D4, D5, D6, D7, D8, D9, D10, D11, D12, D13, D14, D15, D16, D17: RED; LED_0805_2012Metric; MFG_PN LTST-C191KGKT
R11, R12, R13, R14, R15, R16, R17, R18, R19, R20, R21, R22, R23, R24, R25, R26: 680; R_0805_2012Metric; MFG_PN ERJ-6ENF6800V
U7: SN74LVC16T245DGGR; SOP50P810X120-48N; MFG_PN SN74LVC16T245DGGR

Connections:
+1.8V: C34.1, C35.1, U7.7 (VCCB_7), U7.18 (VCCB_18); also elsewhere on the board
+3.3V: C36.1, C37.1, U7.31 (VCCA_31), U7.42 (VCCA_42); also elsewhere on the board
/Fault LED's/fault_led0: U7.2 (1B1); also elsewhere on the board
/Fault LED's/fault_led1: U7.3 (1B2); also elsewhere on the board
/Fault LED's/fault_led2: U7.5 (1B3); also elsewhere on the board
/Fault LED's/fault_led3: U7.6 (1B4); also elsewhere on the board
/Fault LED's/fault_led4: U7.8 (1B5); also elsewhere on the board
/Fault LED's/fault_led5: U7.9 (1B6); also elsewhere on the board
/Fault LED's/fault_led6: U7.11 (1B7); also elsewhere on the board
/Fault LED's/fault_led7: U7.12 (1B8); also elsewhere on the board
/Fault LED's/fault_led8: U7.13 (2B1); also elsewhere on the board
/Fault LED's/fault_led9: U7.14 (2B2); also elsewhere on the board
/Fault LED's/fault_led10: U7.16 (2B3); also elsewhere on the board
/Fault LED's/fault_led11: U7.17 (2B4); also elsewhere on the board
/Fault LED's/fault_led12: U7.19 (2B5); also elsewhere on the board
/Fault LED's/fault_led13: U7.20 (2B6); also elsewhere on the board
/Fault LED's/fault_led14: U7.22 (2B7); also elsewhere on the board
/Fault LED's/fault_led15: U7.23 (2B8); also elsewhere on the board
GND: C34.2, C35.2, C36.2, C37.2, D2.1 (K), D3.1 (K), D4.1 (K), D5.1 (K), D6.1 (K), D7.1 (K), D8.1 (K), D9.1 (K), D10.1 (K), D11.1 (K), D12.1 (K), D13.1 (K), D14.1 (K), D15.1 (K), D16.1 (K), D17.1 (K), U7.1 (1DIR), U7.4 (GND), U7.10 (GND), U7.15 (GND), U7.21 (GND), U7.24 (2DIR), U7.25 (2~OE), U7.28 (GND), U7.34 (GND), U7.39 (GND), U7.45 (GND), U7.48 (1~OE); also elsewhere on the board
unnamed: D2.2 (A), R11.2
unnamed: D3.2 (A), R12.2
unnamed: D4.2 (A), R13.2
unnamed: D5.2 (A), R14.2
unnamed: D6.2 (A), R15.2
unnamed: D7.2 (A), R16.2
unnamed: D8.2 (A), R17.2
unnamed: D9.2 (A), R18.2
unnamed: D10.2 (A), R19.2
unnamed: D11.2 (A), R20.2
unnamed: D12.2 (A), R21.2
unnamed: D13.2 (A), R22.2
unnamed: D14.2 (A), R23.2
unnamed: D15.2 (A), R24.2
unnamed: D16.2 (A), R25.2
unnamed: D17.2 (A), R26.2
unnamed: R11.1, U7.47 (1A1)
unnamed: R12.1, U7.46 (1A2)
unnamed: R13.1, U7.44 (1A3)
unnamed: R14.1, U7.43 (1A4)
unnamed: R15.1, U7.41 (1A5)
unnamed: R16.1, U7.40 (1A6)
unnamed: R17.1, U7.38 (1A7)
unnamed: R18.1, U7.37 (1A8)
unnamed: R19.1, U7.36 (2A1)
unnamed: R20.1, U7.35 (2A2)
unnamed: R21.1, U7.33 (2A3)
unnamed: R22.1, U7.32 (2A4)
unnamed: R23.1, U7.30 (2A5)
unnamed: R24.1, U7.29 (2A6)
unnamed: R25.1, U7.27 (2A7)
unnamed: R26.1, U7.26 (2A8)

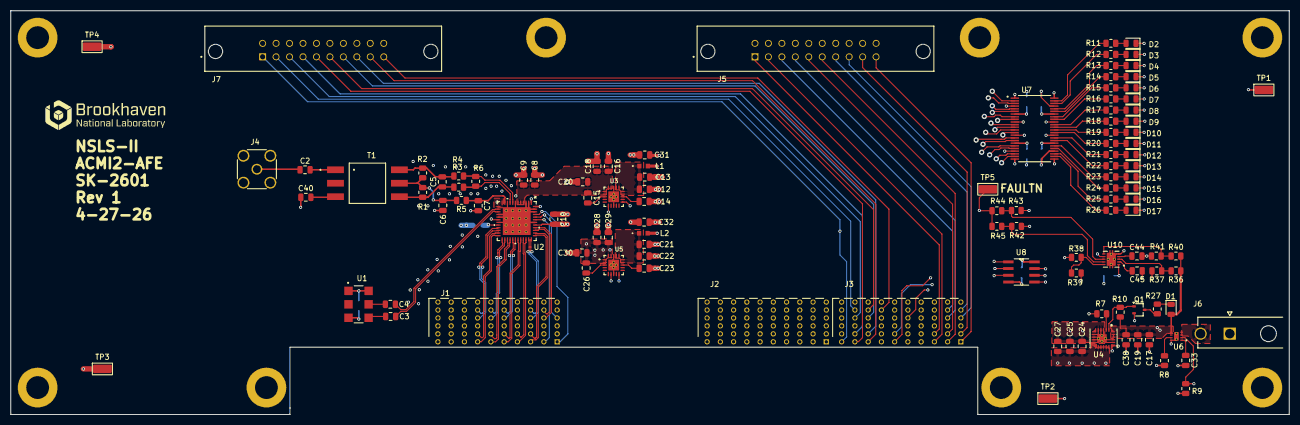
[picture p53: board acmi2-afe.kicad_pcb from above]

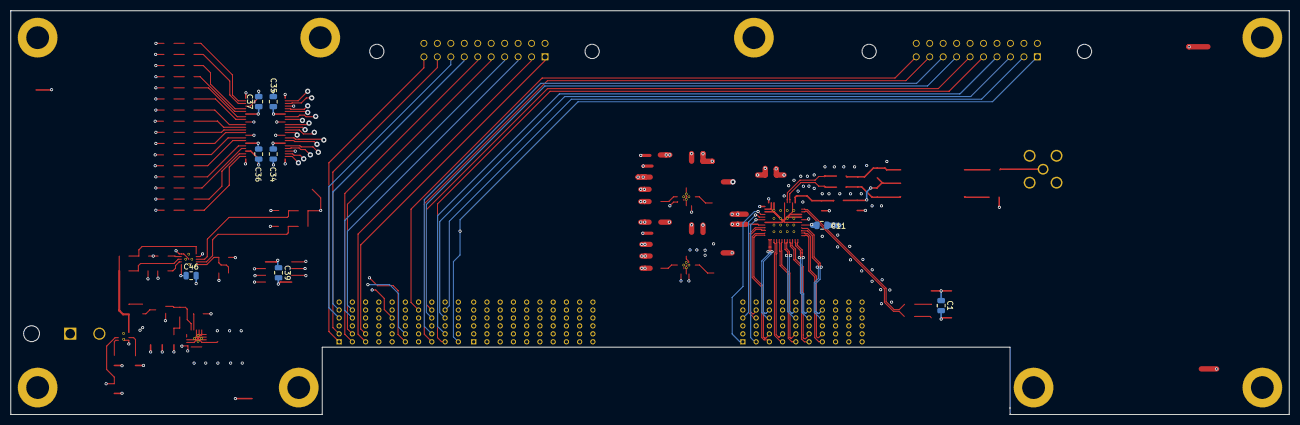
[picture p54: board acmi2-afe.kicad_pcb from below]

Board: 6 copper layers, 241.3 x 76.2 mm, 130 parts (8 on the bottom side), 138 nets.
