capotostobnl/acmi2-hw-afe/(commit log)

2026-05-12 Untangled adc data connections
    [acmi2-afe.kicad_pcb, zudfe_conn.kicad_sch]
2026-05-16 push from windows
    [acmi2-afe.kicad_pcb, acmi2-afe.kicad_sch, relaybrd.kicad_sch]
2026-05-21 Finish routing
    [acmi2-afe.kicad_pcb, acmi2-afe.kicad_sch, adc.kicad_sch, regulator.kicad_sch, relaybrd.kicad_sch, zudfe_conn.kicad_sch]
2026-05-26 Add watchdog window IC
    [TPS3850H33DRCR.STEP, acmi2-afe.kicad_pcb, acmi2-afe.kicad_sch, eeprom.kicad_sch, relaybrd.kicad_sch, zudfe_conn.kicad_sch]
2026-05-26 Finish BOM
    [5v_power_supply.kicad_sch, Fault_leds.kicad_sch, Pulser.kicad_sch, acmi2-afe.kicad_pcb, acmi2-afe.kicad_sch, adc.kicad_sch, burden.kicad_sch, chan.kicad_sch]
2026-05-26 Add fab drawings
    [acmi2-afe-B_Cu - L6 Signal.gbr, acmi2-afe-B_Mask.gbr, acmi2-afe-B_Paste.gbr, acmi2-afe-B_Silkscreen.gbr, acmi2-afe-Edge_Cuts.gbr, acmi2-afe-F_Cu - L1 Signal.gbr, acmi2-afe-F_Fab.gbr, acmi2-afe-F_Mask.gbr]
2026-06-04 Add stitching vias, finalize gerbers
    [acmi2-afe-B_Cu - L6 Signal.gbr, acmi2-afe-B_Mask.gbr, acmi2-afe-B_Paste.gbr, acmi2-afe-B_Silkscreen.gbr, acmi2-afe-Edge_Cuts.gbr, acmi2-afe-F_Cu - L1 Signal.gbr, acmi2-afe-F_Fab.gbr, acmi2-afe-F_Mask.gbr]
2026-06-05 Add drawing borders, moved copper pours inside board edge, add fab notes, update bnl logo
    [Fault_leds.kicad_sch, Pulser.kicad_sch, SK-2601-51_PPB_REV-1.csv, SK-2601-51_PPT_REV-1.csv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]
2026-06-05 Updated via-in-pad, fab notes.
    [acmi2-afe-Drill Drawing.gbr, acmi2-afe-LY01.gbr, acmi2-afe-LY02.gbr, acmi2-afe-LY03.gbr, acmi2-afe-LY04.gbr, acmi2-afe-LY05.gbr, acmi2-afe-LY06.gbr, acmi2-afe-SMB.gbr]
2026-06-10 Nightly commit
    [SK-2601-51_PPB_REV-1.csv, SK-2601-51_PPT_REV-1.csv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]
